DarqSh/bap-novosad/NSI/NSI_latex_submit/design/design.tex

\chapter{Design of a Platform}
This chapter will firstly go over the existing DIY solutions for 360° LiDAR platforms discovered during the research for this project, analysing their pros and cons.
Subsequently, the proposed design is presented, along with the chosen design decisions and their justifications.

\input{design/existing_solutions/existing_solutions.tex}
\input{design/proposed_design/proposed_design.tex}
\input{design/gearbox_design/gearbox_design.tex}
\input{design/platform_showcase/platform_showcase.tex}
