DarqSh/bap-novosad/NSI/NSI_latex_submit/design/existing_solutions/existing_solutions.tex

\section{Existing Amateur Solutions for Environmental Mapping}
\label{sec:amateur_solutions}
\subsection{Using a Single-Point \gls{lidar} module}

One of the most straightforward approaches to achieve 360° environmental mapping is to utilise a single-point \gls{lidar} module mounted on a platform which can rotate and tilt. 
The implementation could be found in \cite{lidar_design_1}.
\begin{figure}
    \centering
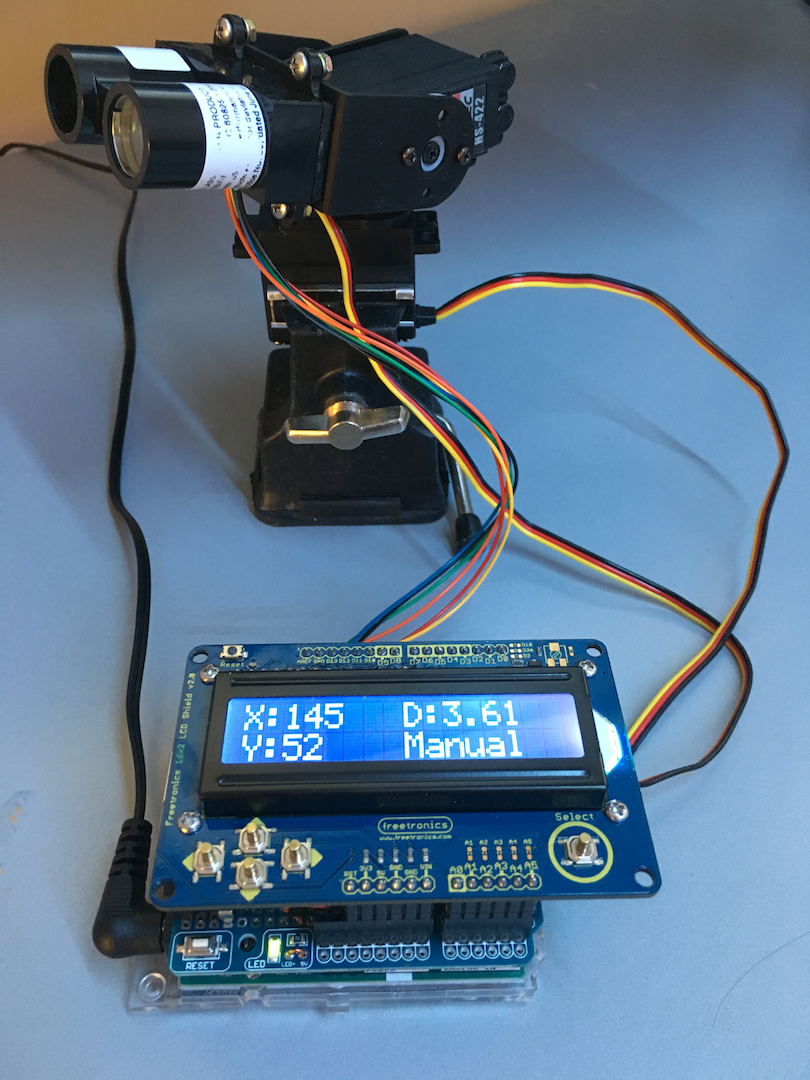
[picture p7: NSI/NSI_latex_submit/design/existing_solutions/3D_1.png]
    
    \caption{Implementation in project \cite{lidar_design_1} using a single-point \gls{lidar}}
    \label{ph:lidar_design_1}
\end{figure}

\begin{tabular}{p{0.45\linewidth} p{0.45\linewidth}}
\textbf{Pros} & \textbf{Cons} \\
\begin{itemize}[label=\textcolor{green!60!black}{\textbf{+}}]
    \item Single-point \gls{lidar}s are the most cost-effective among all existing types
    \item Simple design
\end{itemize}
&
\begin{itemize}[label=\textcolor{red!70!black}{\textbf{--}}]
    \item Slow data acquisition relative to methods leveraging 2D \gls{lidar}'s speed
    \item Movement of lidar may introduce inaccuracies in distance measurements, which need to be compensated for in code if we want to assume that all points are measured from a single position in space
\end{itemize}
\end{tabular}

\subsection{Using a Single-Point \gls{lidar} and a Mirror}
The following approach was used in \cite{lidar_design_2}. A single-point \gls{lidar} is placed below a rotating mirror, which reflects the laser beam horizontally. 
As the mirror rotates, the laser beam scans the environment in 360-degree sweep. 
Moreover, by tilting the mirror at an angle, vertical scanning can also be achieved, allowing for the acquisition of the whole scene.

\begin{figure}
    \centering
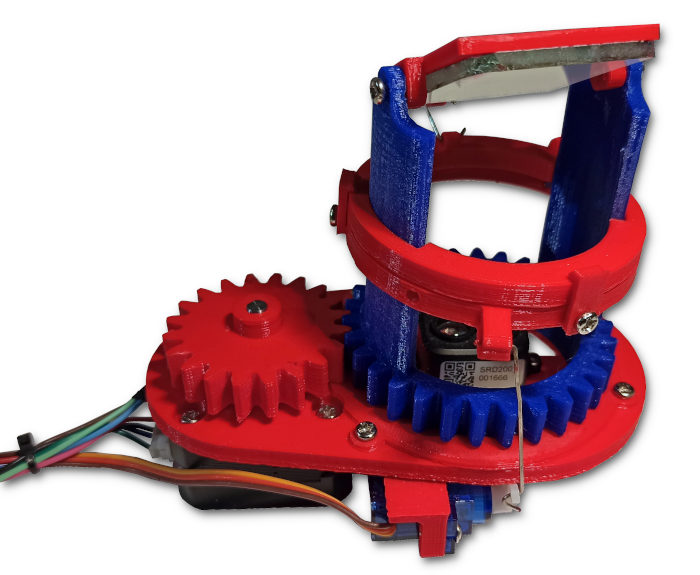
[picture p8: NSI/NSI_latex_submit/design/existing_solutions/3D_2.jpg]
    
    \caption{Implementation in project \cite{lidar_design_2} using a single-point \gls{lidar} and a mirror}
    \label{ph:lidar_design_2}
\end{figure}

\begin{tabular}{p{0.45\linewidth} p{0.45\linewidth}}
\textbf{Pros} & \textbf{Cons} \\
\begin{itemize}[label=\textcolor{green!60!black}{\textbf{+}}]
    \item Cost-effectiveness as in previous implementation
    \item Simple design
    \item Much easier to correct the distance measurement since the \gls{lidar} is stationary and the distance from it to the mirror is known.
\end{itemize}
&
\begin{itemize}[label=\textcolor{red!70!black}{\textbf{--}}]
    \item Slow data acquisition relative to methods leveraging 2D \gls{lidar}'s speed
    \item Mirror quality may affect the accuracy of distance measurements
    \item Mechanical structure holding the mirror may introduce vibrations, thus affecting measurement accuracy
\end{itemize}
\end{tabular}

\subsection{Using a 2D \gls{lidar} Mounted on a Tilting Platform}
\label{sec:tilting_platform}
This approach utilises a 2D \gls{lidar} sensor mounted on a platform that can tilt the sensor side to side, as demonstrated in \cite{lidar_design_3}. The 2D \gls{lidar} scans the environment in a horizontal plane, while the tilting mechanism allows for vertical scanning.

\begin{figure}
    \centering
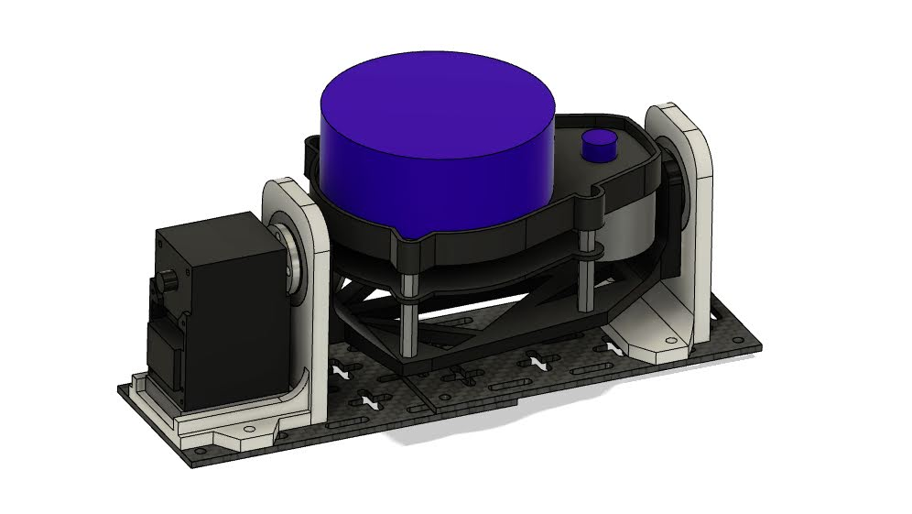
[picture p9: NSI/NSI_latex_submit/design/existing_solutions/3D_3.jpg]
    
    \caption{Implementation in project \cite{lidar_design_3} using a tilting platform}
    \label{ph:lidar_design_3}
\end{figure}

\begin{tabular}{p{0.45\linewidth} p{0.45\linewidth}}
\textbf{Pros} & \textbf{Cons} \\
\begin{itemize}[label=\textcolor{green!60!black}{\textbf{+}}]
    \item Faster data acquisition compared to solutions with single-point \gls{lidar} measurements
    \item Higher resolution given by the use of a 2D \gls{lidar} sensor
    \item This design could be potentially used for \gls{slam} applications, given the higher speed
\end{itemize}
&
\begin{itemize}[label=\textcolor{red!70!black}{\textbf{--}}]
    \item More expensive than single-point \gls{lidar} solutions
    \item Point distribution is non-uniform due to the tilting mechanism, which produces denser point clouds on the axis of tilting (see \cref{fig:tilt_pointCloud})
    \item Mechanical design is more prone to vibrations produced by the \gls{lidar} itself, affecting measurement accuracy
\end{itemize}
\end{tabular}
\begin{figure}[H]
    \centering
    \input{design/existing_solutions/tilt_pointCloud.tex}
    \caption{Simulation of an obtained point cloud using a tilting platform}
    \label{fig:tilt_pointCloud}
\end{figure}
