DarqSh/bap-novosad/NSI/NSI_latex_submit/zadani.tex

\chapter{Specification of Assignment}
There are used various methods based on the evaluation of the ranging signal to map the topology of the
environment. Study these methods with a focus on the use of lidar signals. Based on the study results, design
a method and algorithms for using a directional beam lidar module or an omnidirectional lidar module for
scanning a 3D space. Assume that the lidar will be mounted on a platform that will either be linearly lifted,
angularly tilted and/or rotated. The goal is to design the processing of the output signal of the lidar module so
that a 3D image of the scanned space can be displayed and propose the construction solution of the lidar
installation.
