DarqSh/bap-novosad/psani_miniproject/miniproject/_glossary.tex

\usepackage[toc=false]{glossaries-extra} % glossary functionality for acronyms
\setabbreviationstyle[acronym]{long-short} % the first time an abbreviation is used, it will be represented in long-short format
\newacronym{lidar}{LiDAR}{Light Detection and Ranging} %\newacronym{label}{abbrv}{long}
\newacronym{dsp}{DSP}{Digital Signal Processing}
\newacronym{slam}{SLAM}{Simultaneous Localisation and Mapping}
\makeglossaries
