DarqSh/bap-novosad/defense_presentation/main_presentation.pdf

## 3D Mapping Based on LiDAR Signal Processing

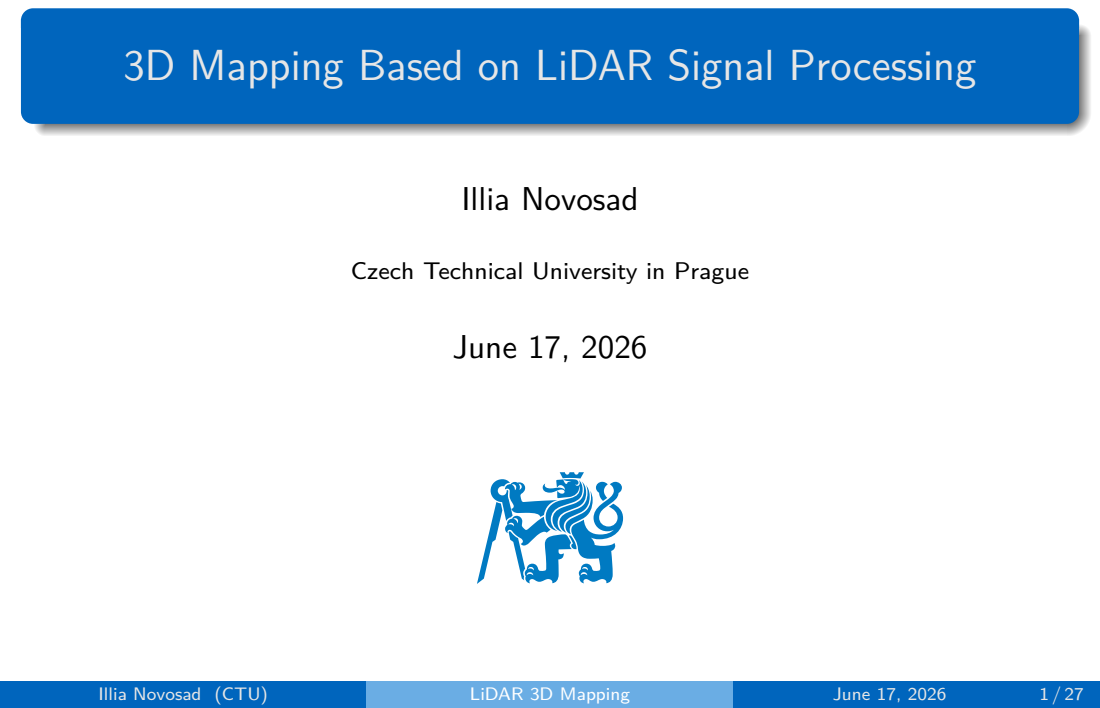
[picture p28: page 1]
Illia Novosad; Illia Novosad (CTU); LiDAR 3D Mapping; June 17, 2026

Czech Technical University in Prague
June 17, 2026

## Obsah

1 Introduction
2 Platform Design
Existing Amateur Solutions for 3D Scanning Point Cloud Visualisation at Different Tilt Angles Dependence of Scan Spacing Sscan on Tilt Angle θ Effect of Reduction Ratio R on Scan Spacing Sscan Platform Showcase
3 Electronics and Software
Electronic Design
Software Architecture
4 Experimental Results
Room Scan
Transformation Corrections Comparison with a Photograph
5 Conclusion
6 Odpovědi na otázky
Illia Novosad (CTU) | LiDAR 3D Mapping | June 17, 2026 | 2 / 27

## Introduction

Commercially available 3D LiDAR solutions:


Unitree 4D L1

Price: 250 e

Solution: use a cheaper 2D LiDAR and design a stepper-motor-driven platform for it

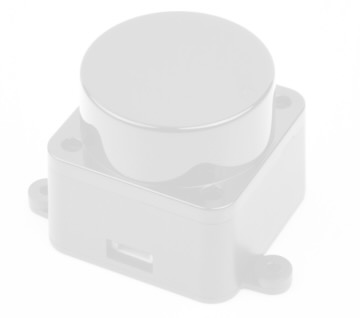
[picture p29: figure]

STL-19P (https://amzn.eu/d/0cCyszli)

Price: 80 e

Illia Novosad (CTU) | LiDAR 3D Mapping | June 17, 2026 | 3 / 27

## Introduction

Commercially available 3D LiDAR solutions:

Unitree 4D L1

Price: 250 e

Solution: use a cheaper 2D LiDAR and design a stepper-motor-driven platform for it


STL-19P (https://amzn.eu/d/0cCyszli)

Price: 80 e

Illia Novosad (CTU) | LiDAR 3D Mapping | June 17, 2026 | 3 / 27

## Table of Contents

1 Introduction
2 Platform Design
Existing Amateur Solutions for 3D Scanning Point Cloud Visualisation at Different Tilt Angles Dependence of Scan Spacing Sscan on Tilt Angle θ Effect of Reduction Ratio R on Scan Spacing Sscan Platform Showcase
3 Electronics and Software
Electronic Design
Software Architecture
4 Experimental Results
Room Scan
Transformation Corrections Comparison with a Photograph
5 Conclusion
6 Odpovědi na otázky
Illia Novosad (CTU) | LiDAR 3D Mapping | June 17, 2026 | 4 / 27

## Existing Amateur Solutions for 3D Scanning

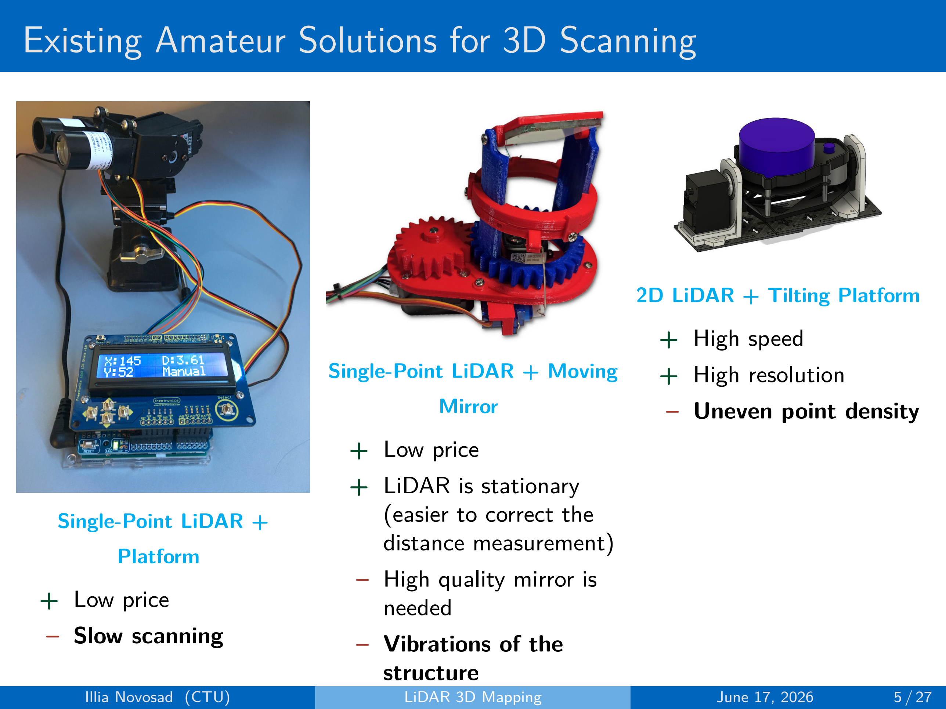
[picture p30: page 6]

Single-Point LiDAR +
Platform (https://www.qcontinuum.org/lidar-scanner)
+ Low price
– Slow scanning

Single-Point LiDAR + Moving Mirror (https://charleslabs.fr/en/project-3D+Lidar+Scanner+MK2)
+ Low price
+ LiDAR is stationary
(easier to correct the
distance measurement)
– High quality mirror is
needed
– Vibrations of the
structure

2D LiDAR + Tilting Platform (http://zlethic.com/diy-3dlidar/) + High speed
+ High resolution
– Uneven point density
Illia Novosad (CTU) | LiDAR 3D Mapping | June 17, 2026 | 5 / 27

## Point Cloud Visualisation at Different Tilt Angles

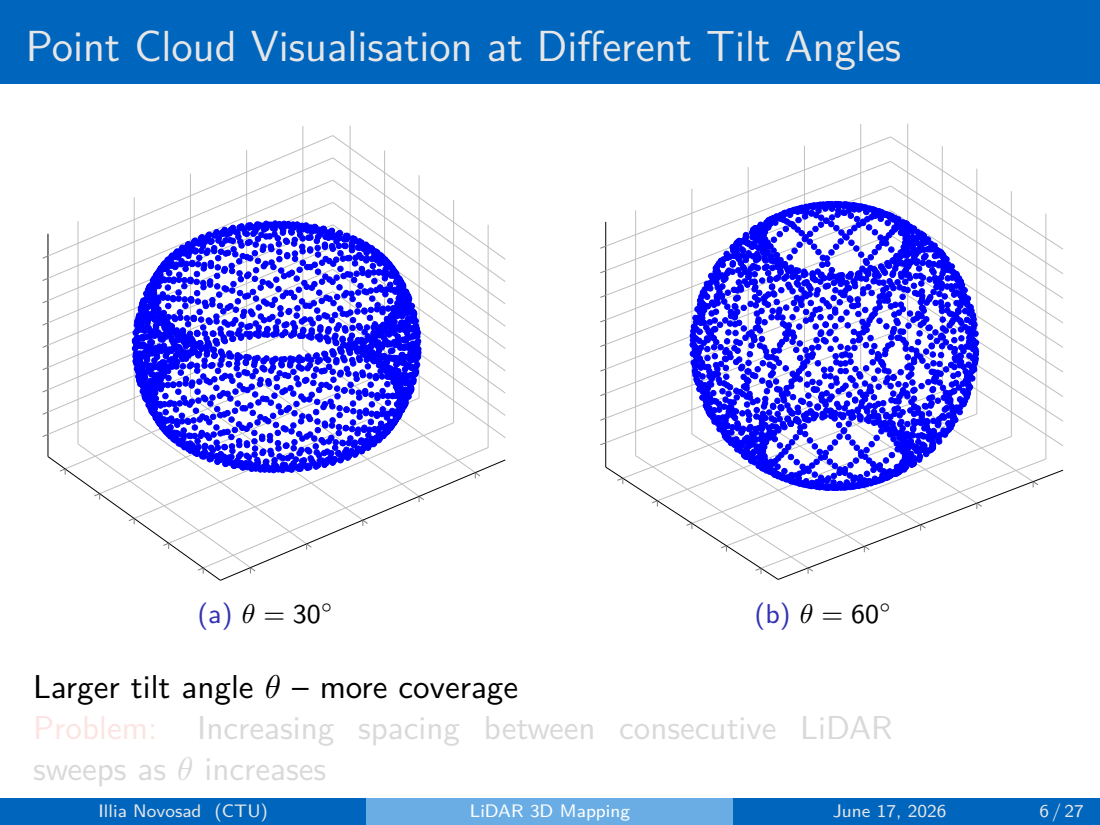
[picture p31: page 7]
Illia Novosad (CTU); LiDAR 3D Mapping; June 17, 2026

Larger tilt angle θ – more coverage
Problem: Increasing spacing between consecutive LiDAR
sweeps as θ increases

## Point Cloud Visualisation at Different Tilt Angles

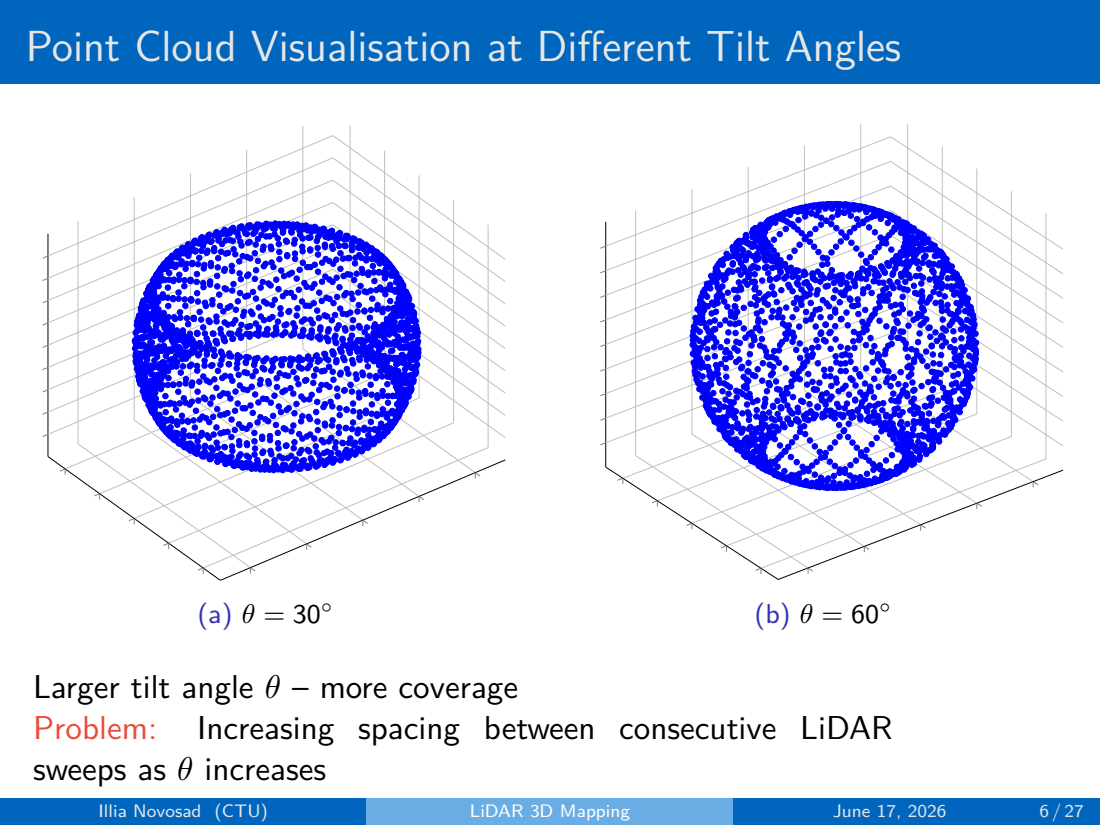
[picture p32: page 8]
Illia Novosad (CTU); LiDAR 3D Mapping; June 17, 2026

Larger tilt angle θ – more coverage
Problem: Increasing spacing between consecutive LiDAR
sweeps as θ increases

## Dependence of Scan Spacing Sscan on Tilt Angle θ

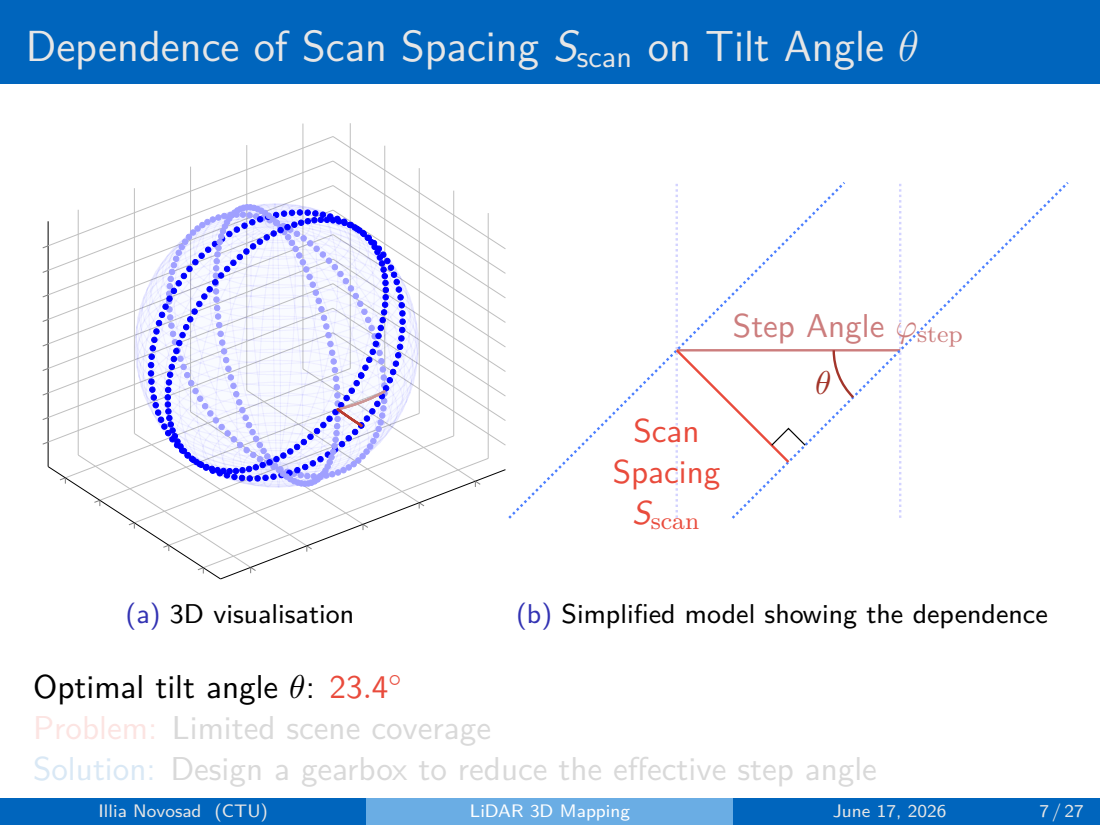
[picture p33: page 9]
Scan Spacing Sscan; Illia Novosad (CTU); LiDAR 3D Mapping; June 17, 2026

Step Angle ϕstep

(a) 3D visualisation
Optimal tilt angle θ: 23.4
Problem: Limited scene coverage
Solution: Design a gearbox to reduce the effective step angle

(b) Simplified model showing the dependence

## Dependence of Scan Spacing Sscan on Tilt Angle θ

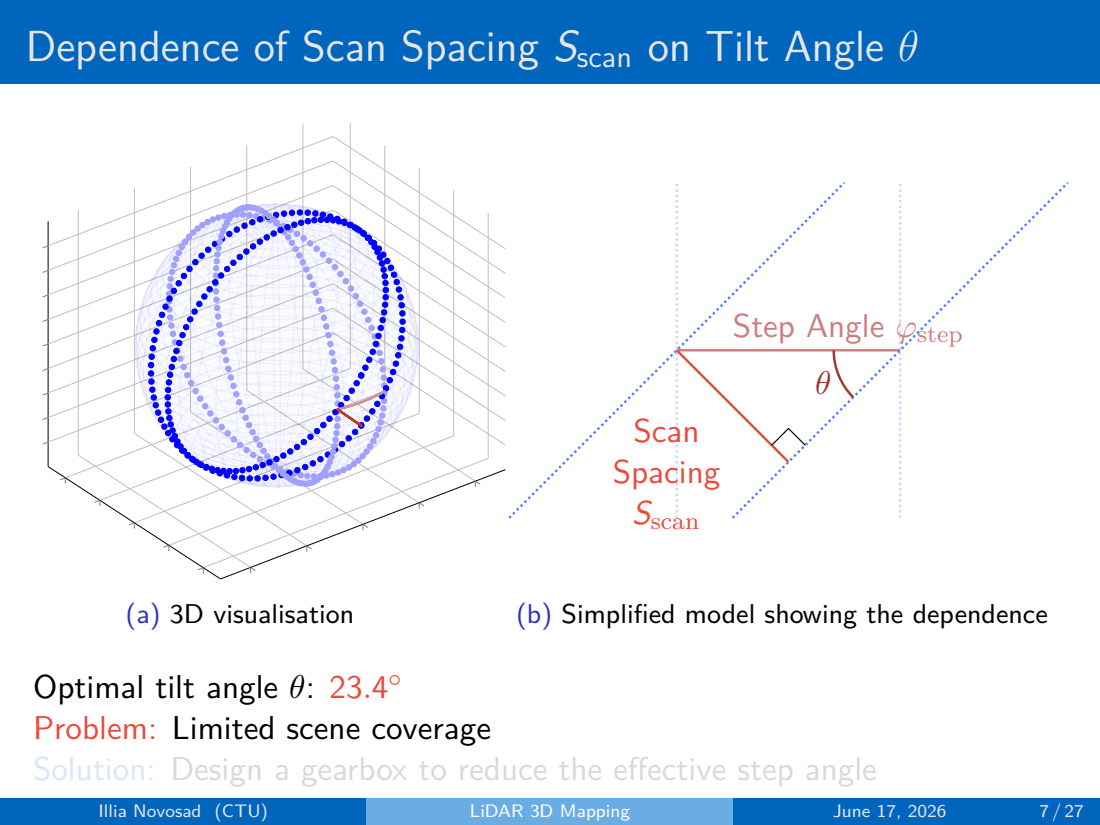
[picture p34: page 10]
Scan Spacing Sscan; Illia Novosad (CTU); LiDAR 3D Mapping; June 17, 2026

Step Angle ϕstep

(a) 3D visualisation
Optimal tilt angle θ: 23.4
Problem: Limited scene coverage
Solution: Design a gearbox to reduce the effective step angle

(b) Simplified model showing the dependence

## Dependence of Scan Spacing Sscan on Tilt Angle θ

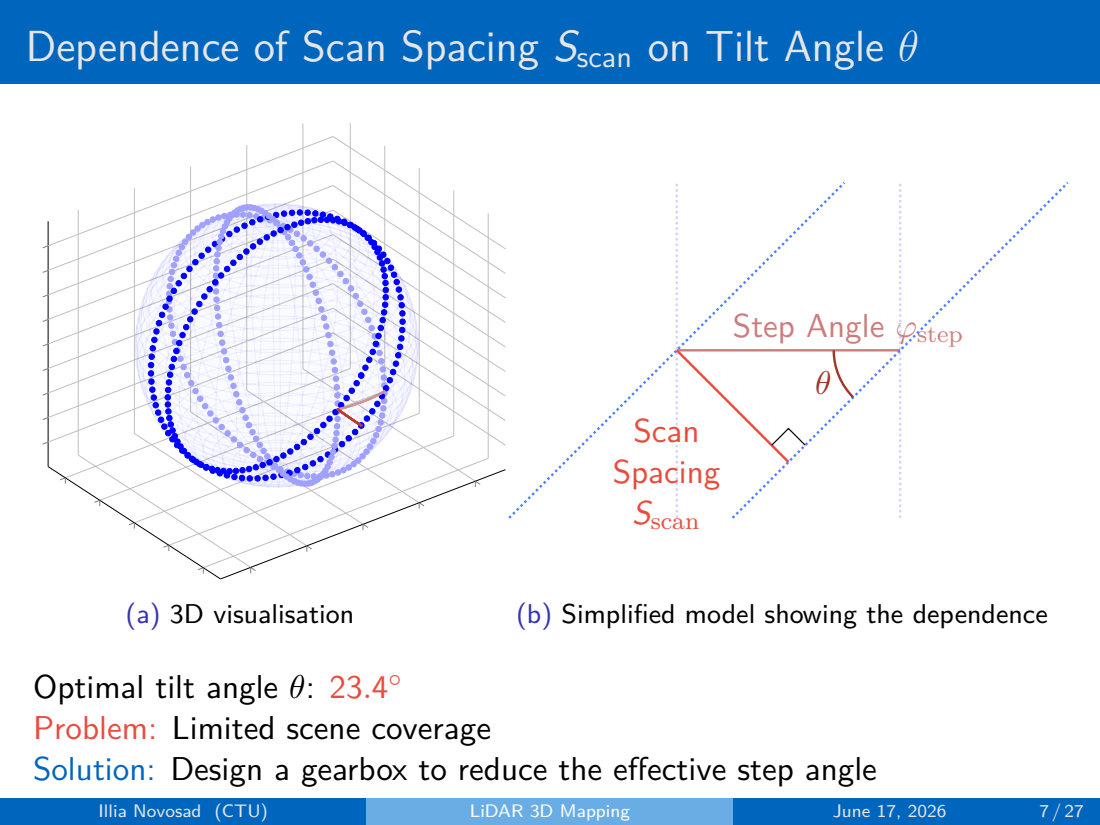
[picture p35: page 11]
Scan Spacing Sscan; Illia Novosad (CTU); LiDAR 3D Mapping; June 17, 2026

Step Angle ϕstep

(a) 3D visualisation
Optimal tilt angle θ: 23.4
Problem: Limited scene coverage
Solution: Design a gearbox to reduce the effective step angle

(b) Simplified model showing the dependence

## Effect of Reduction Ratio R on Scan Spacing Sscan

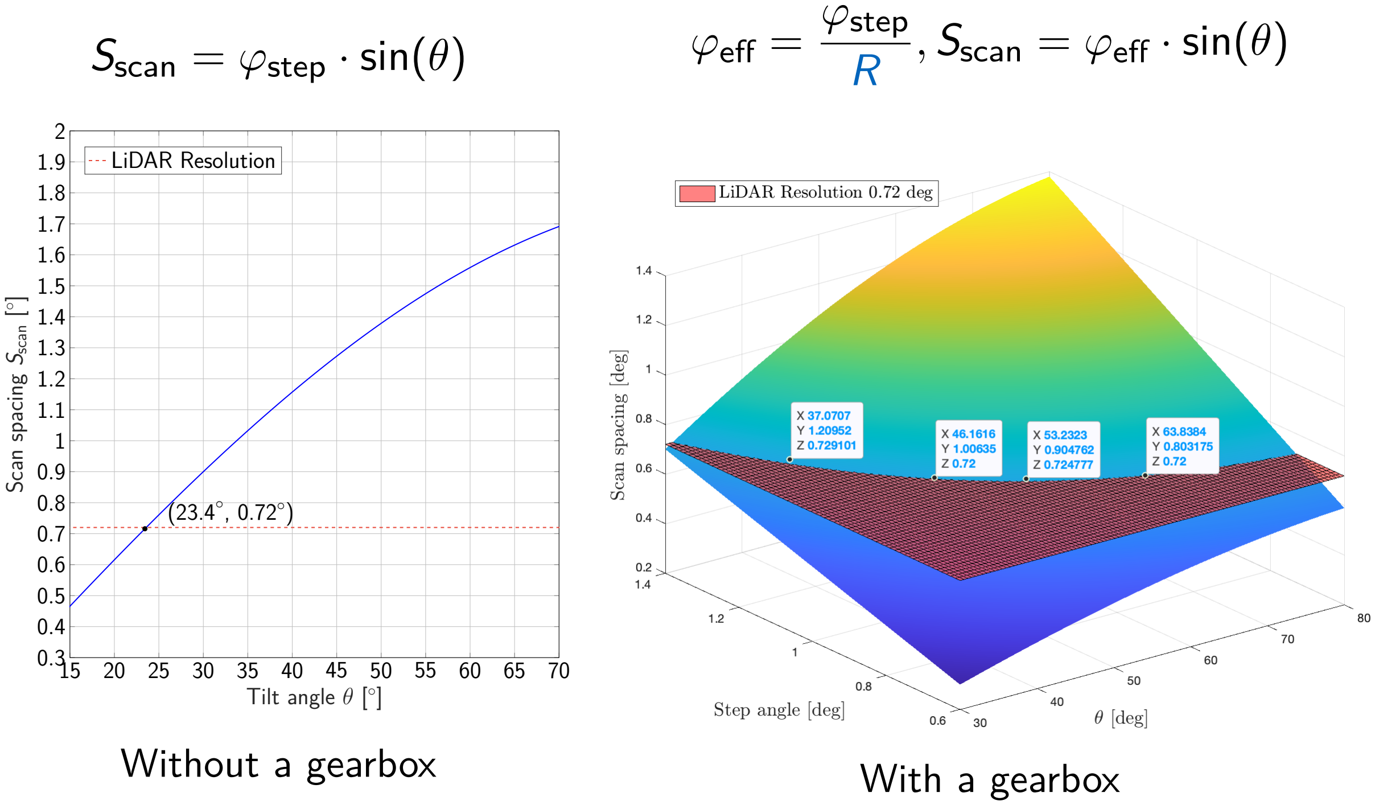
[picture p36: figure]
Sscan = ϕstep · sin(θ); Tilt angle θ [◦; ] Scan spacing Sscan [◦; LiDAR Resolution; Without a gearbox; ϕeff =; ϕstep R; , Sscan = ϕeff · sin(θ); With a gearbox

Illia Novosad (CTU) | LiDAR 3D Mapping | June 17, 2026 | 8 / 27

## Platform Showcase

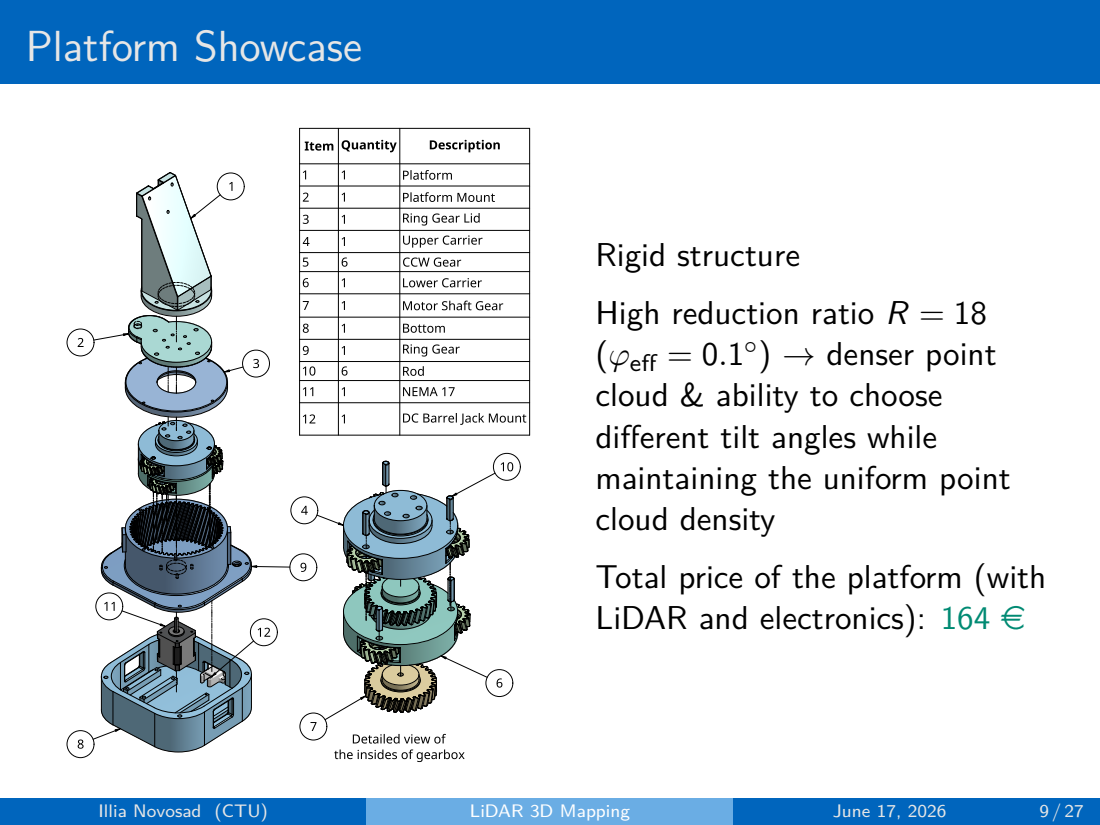
[picture p37: page 13]
) → denser point; Illia Novosad (CTU); LiDAR 3D Mapping; June 17, 2026

Rigid structure
High reduction ratio R = 18
(ϕeff = 0.1
cloud & ability to choose
different tilt angles while
maintaining the uniform point
cloud density
Total price of the platform (with
LiDAR and electronics): 164 e

## Table of Contents

1 Introduction
2 Platform Design
Existing Amateur Solutions for 3D Scanning Point Cloud Visualisation at Different Tilt Angles Dependence of Scan Spacing Sscan on Tilt Angle θ Effect of Reduction Ratio R on Scan Spacing Sscan Platform Showcase
3 Electronics and Software
Electronic Design
Software Architecture
4 Experimental Results
Room Scan
Transformation Corrections Comparison with a Photograph
5 Conclusion
6 Odpovědi na otázky
Illia Novosad (CTU) | LiDAR 3D Mapping | June 17, 2026 | 10 / 27

## Electronic Design

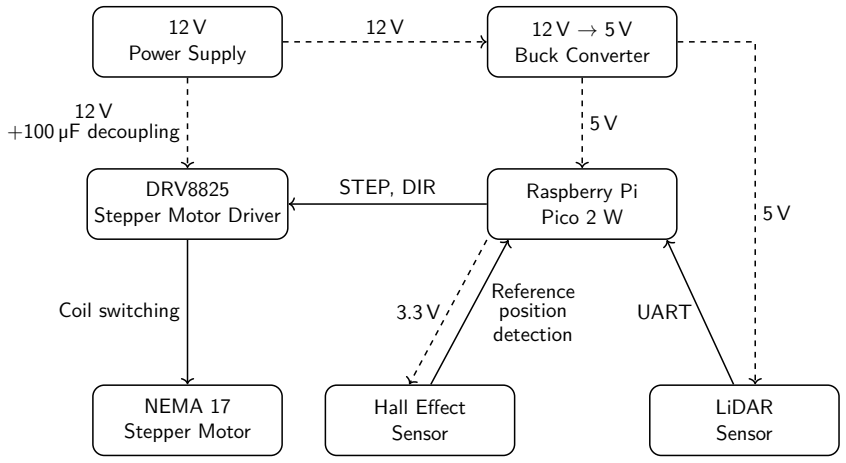
[picture p38: figure]
12 V Power Supply; DRV8825 Stepper Motor Driver; 12 V → 5 V Buck Converter; NEMA 17 Stepper Motor; Raspberry Pi Pico 2 W; LiDAR Sensor; Hall Effect Sensor; 12 V +100 µF decoupling; Coil switching; STEP, DIR; UART; Reference position detection

Illia Novosad (CTU) | LiDAR 3D Mapping | June 17, 2026 | 11 / 27

## Software Architecture

LiDAR | Pico 2 W | PC | Open3D UART | Wi-Fi

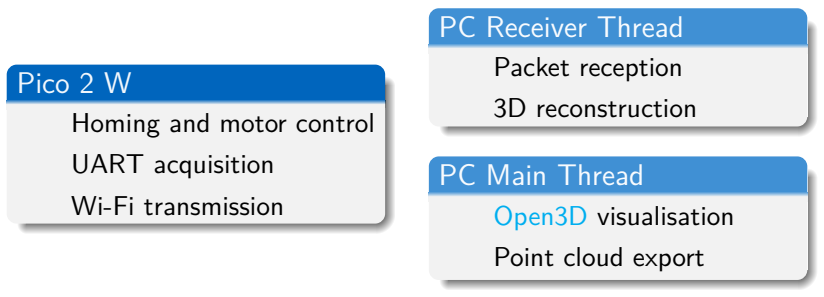
[picture p39: figure]
Pico 2 W Homing and motor control UART acquisition Wi-Fi transmission; PC Receiver Thread Packet reception 3D reconstruction PC Main Thread Open3D visualisation Point cloud export

Illia Novosad (CTU) | LiDAR 3D Mapping | June 17, 2026 | 12 / 27

## Table of Contents

1 Introduction
2 Platform Design
Existing Amateur Solutions for 3D Scanning Point Cloud Visualisation at Different Tilt Angles Dependence of Scan Spacing Sscan on Tilt Angle θ Effect of Reduction Ratio R on Scan Spacing Sscan Platform Showcase
3 Electronics and Software
Electronic Design
Software Architecture
4 Experimental Results
Room Scan
Transformation Corrections Comparison with a Photograph
5 Conclusion
6 Odpovědi na otázky
Illia Novosad (CTU) | LiDAR 3D Mapping | June 17, 2026 | 13 / 27

## Room Scan

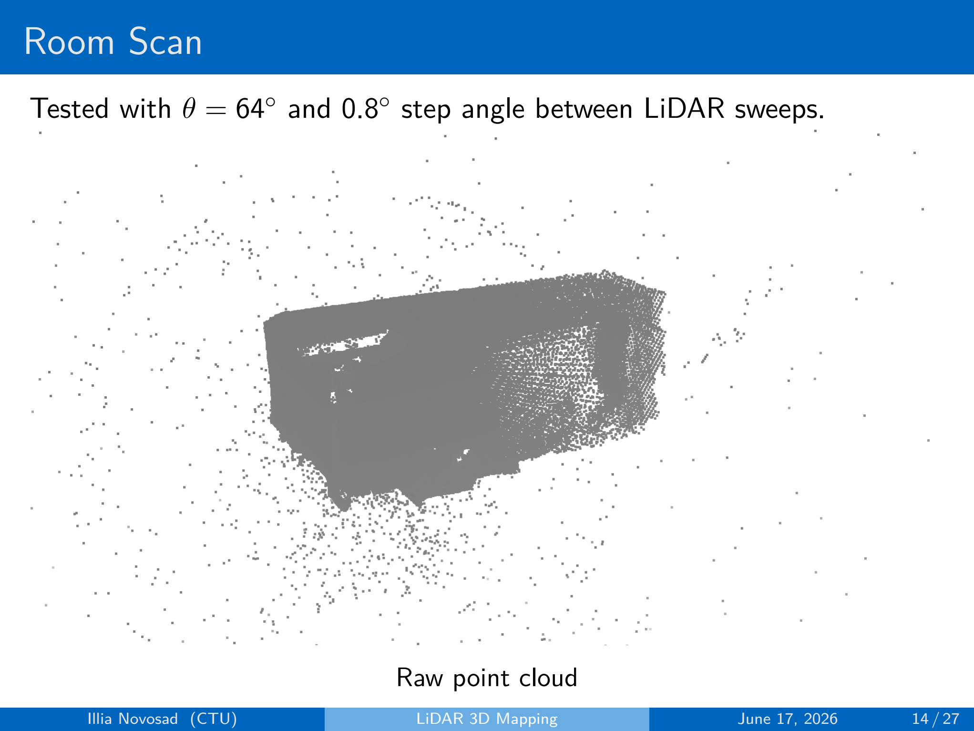
[picture p40: page 18]

Tested with θ = 64◦

and 0.8◦

step angle between LiDAR sweeps.

Raw point cloud

Illia Novosad (CTU) | LiDAR 3D Mapping | June 17, 2026 | 14 / 27

## Room Scan

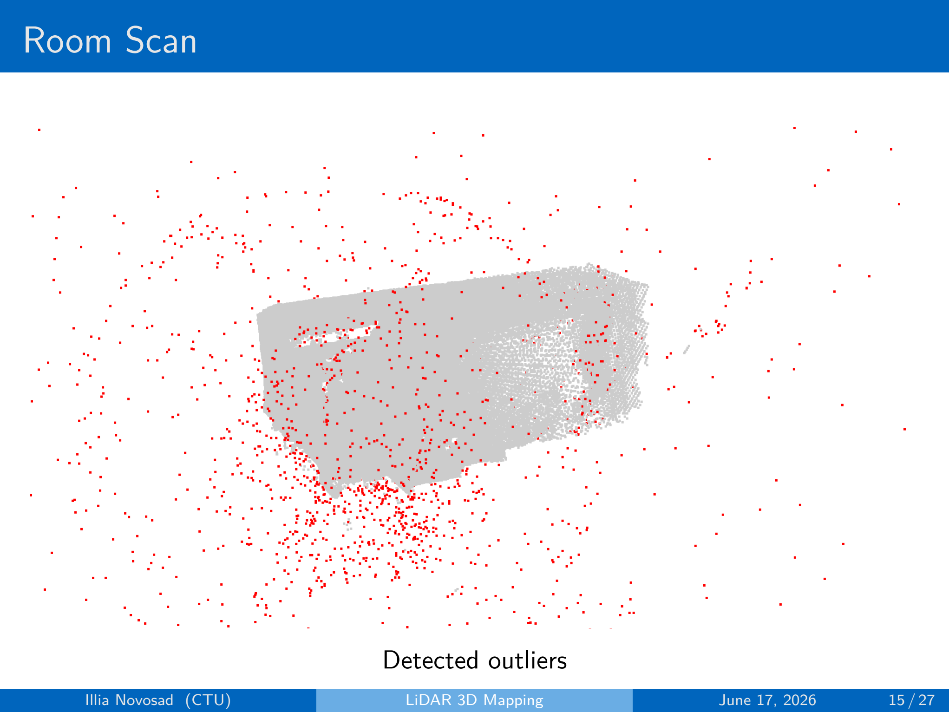
[picture p41: page 19]

Detected outliers

Illia Novosad (CTU) | LiDAR 3D Mapping | June 17, 2026 | 15 / 27

## Room Scan

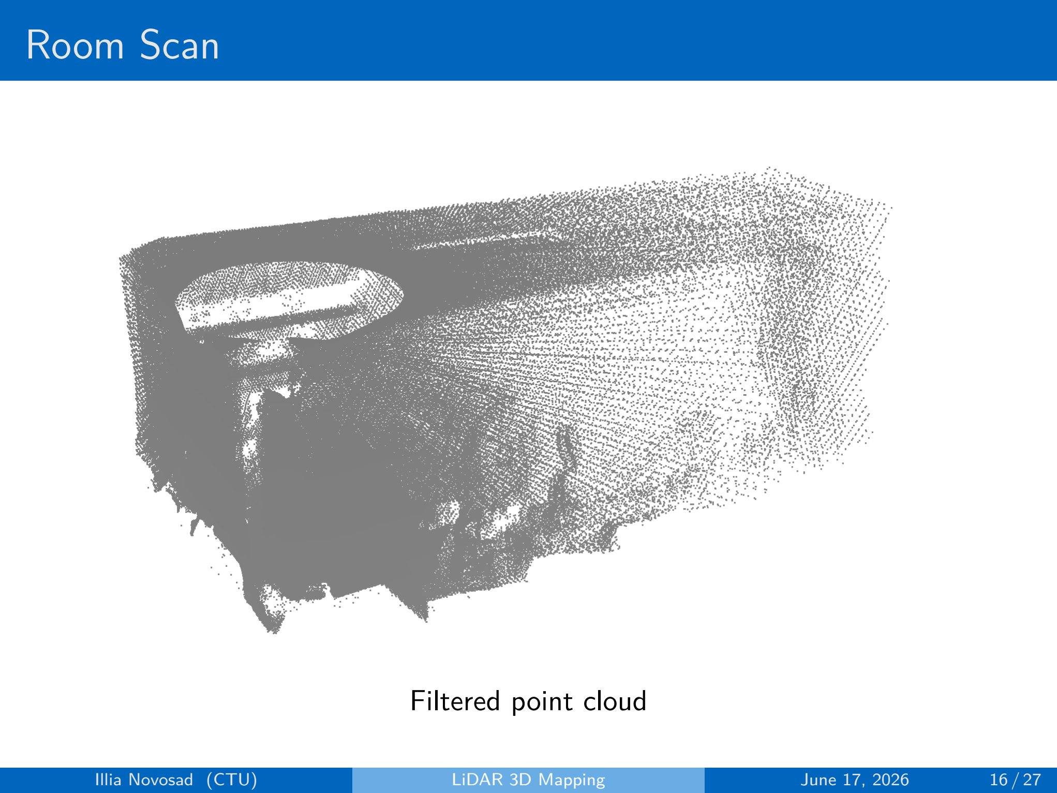
[picture p42: page 20]

Filtered point cloud

Illia Novosad (CTU) | LiDAR 3D Mapping | June 17, 2026 | 16 / 27

## Transformation Corrections

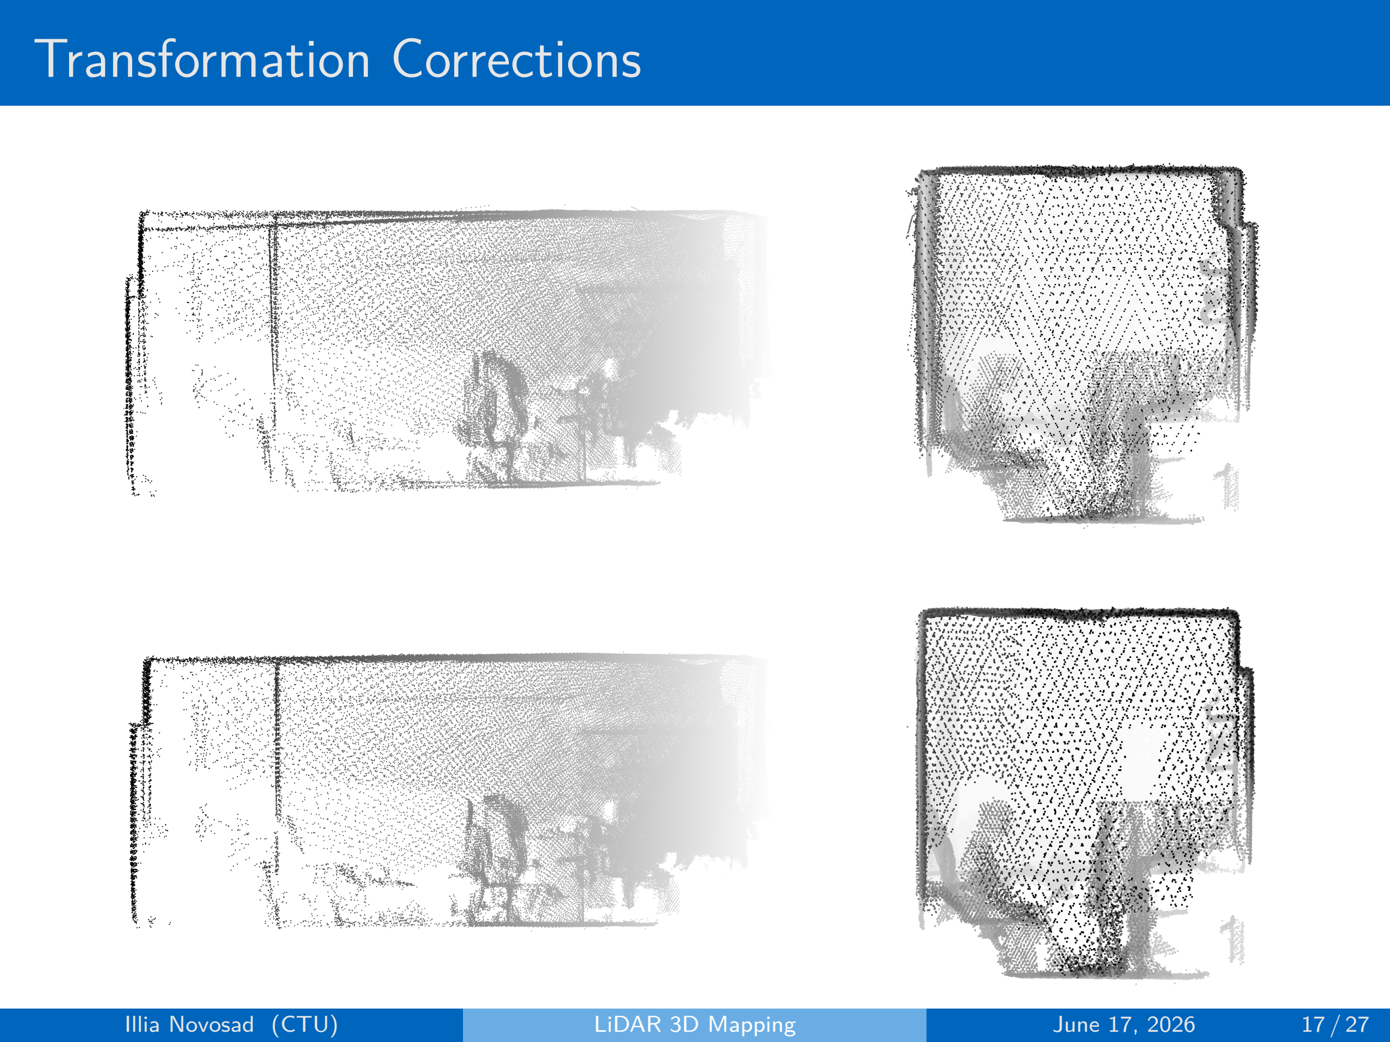
[picture p43: page 21]

Illia Novosad (CTU) | LiDAR 3D Mapping | June 17, 2026 | 17 / 27

## Comparison with a Photograph

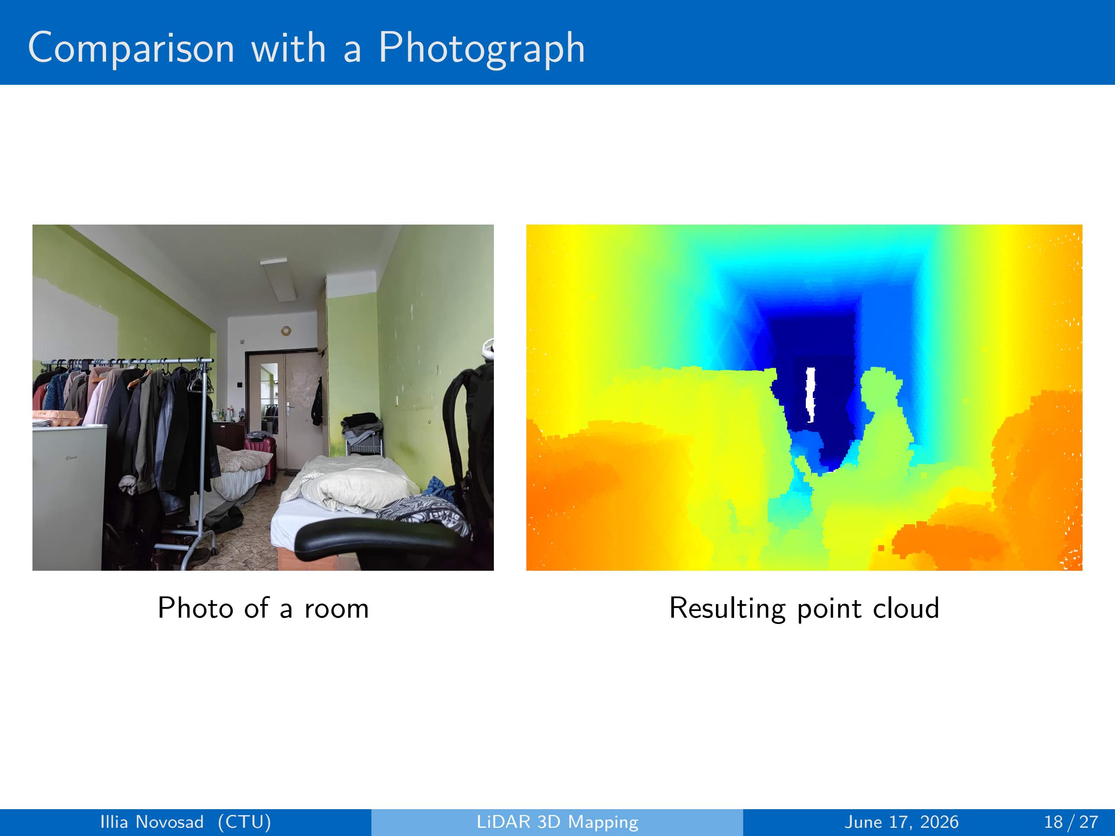
[picture p44: page 22]

Photo of a room | Resulting point cloud
Illia Novosad (CTU) | LiDAR 3D Mapping | June 17, 2026 | 18 / 27

## Table of Contents

1 Introduction
2 Platform Design
Existing Amateur Solutions for 3D Scanning Point Cloud Visualisation at Different Tilt Angles Dependence of Scan Spacing Sscan on Tilt Angle θ Effect of Reduction Ratio R on Scan Spacing Sscan Platform Showcase
3 Electronics and Software
Electronic Design
Software Architecture
4 Experimental Results
Room Scan
Transformation Corrections Comparison with a Photograph
5 Conclusion
6 Odpovědi na otázky
Illia Novosad (CTU) | LiDAR 3D Mapping | June 17, 2026 | 19 / 27

## Conclusion

A platform enabling 3D reconstruction with 2D LiDAR was built. It features a gearbox with a high reduction ratio, allowing for dense point clouds even at large tilt angles.
Code for data acquisition, processing and 3D reconstruction visualisation was written.
The prototype was tested by scanning a room, transformation corrections were applied.
Illia Novosad (CTU) | LiDAR 3D Mapping | June 17, 2026 | 20 / 27

# Thank you for your attention!

Illia Novosad (CTU) | LiDAR 3D Mapping | June 17, 2026 | 21 / 27

## Table of Contents

1 Introduction
2 Platform Design
Existing Amateur Solutions for 3D Scanning Point Cloud Visualisation at Different Tilt Angles Dependence of Scan Spacing Sscan on Tilt Angle θ Effect of Reduction Ratio R on Scan Spacing Sscan Platform Showcase
3 Electronics and Software
Electronic Design
Software Architecture
4 Experimental Results
Room Scan
Transformation Corrections Comparison with a Photograph
5 Conclusion
6 Odpovědi na otázky
Illia Novosad (CTU) | LiDAR 3D Mapping | June 17, 2026 | 22 / 27

## Odpovědi na otázky

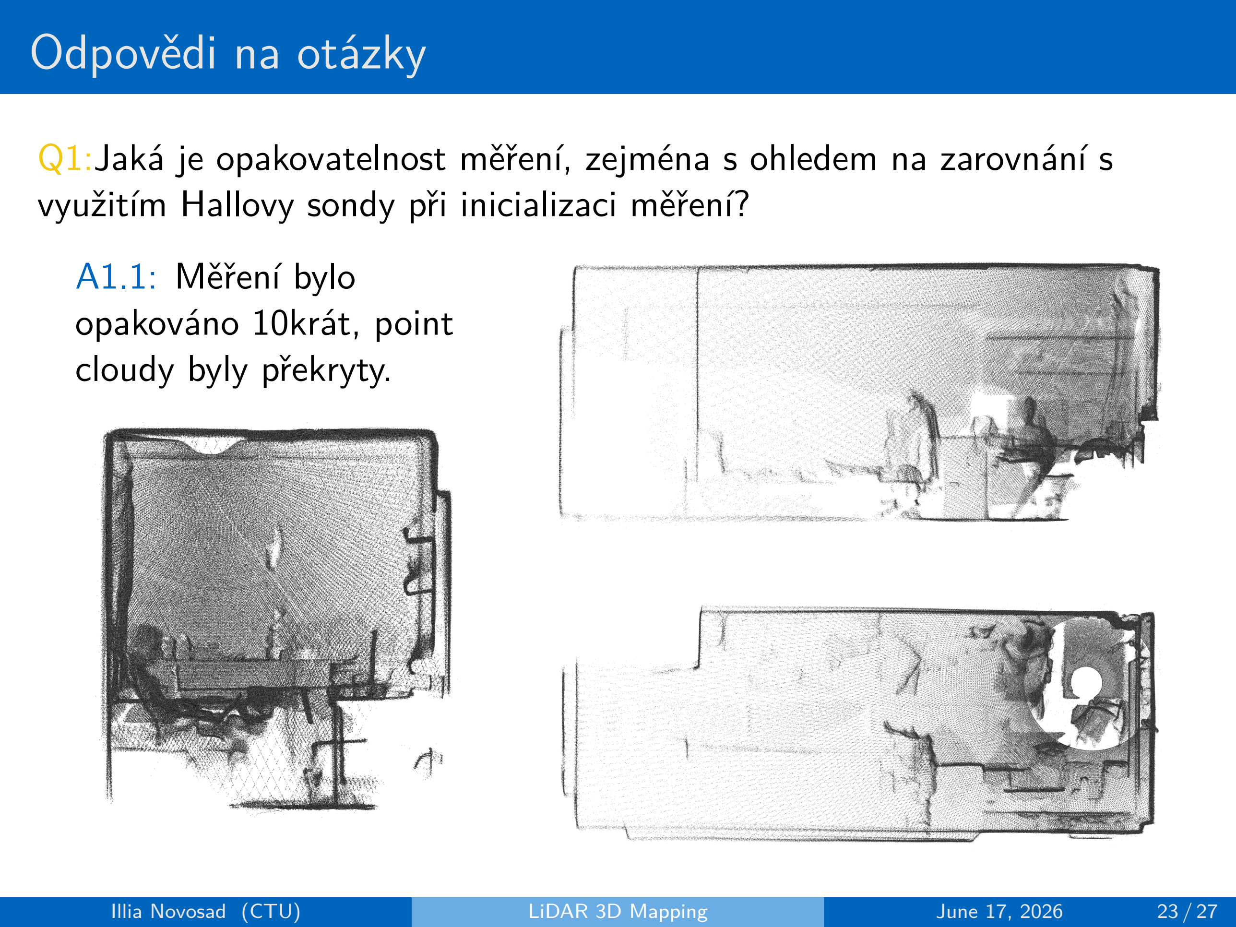
[picture p45: page 27]

Q1:Jaká je opakovatelnost měření, zejména s ohledem na zarovnání s využitím Hallovy sondy při inicializaci měření?
A1.1: Měření bylo
opakováno 10krát, point
cloudy byly překryty.
Illia Novosad (CTU) | LiDAR 3D Mapping | June 17, 2026 | 23 / 27

## Odpovědi na otázky

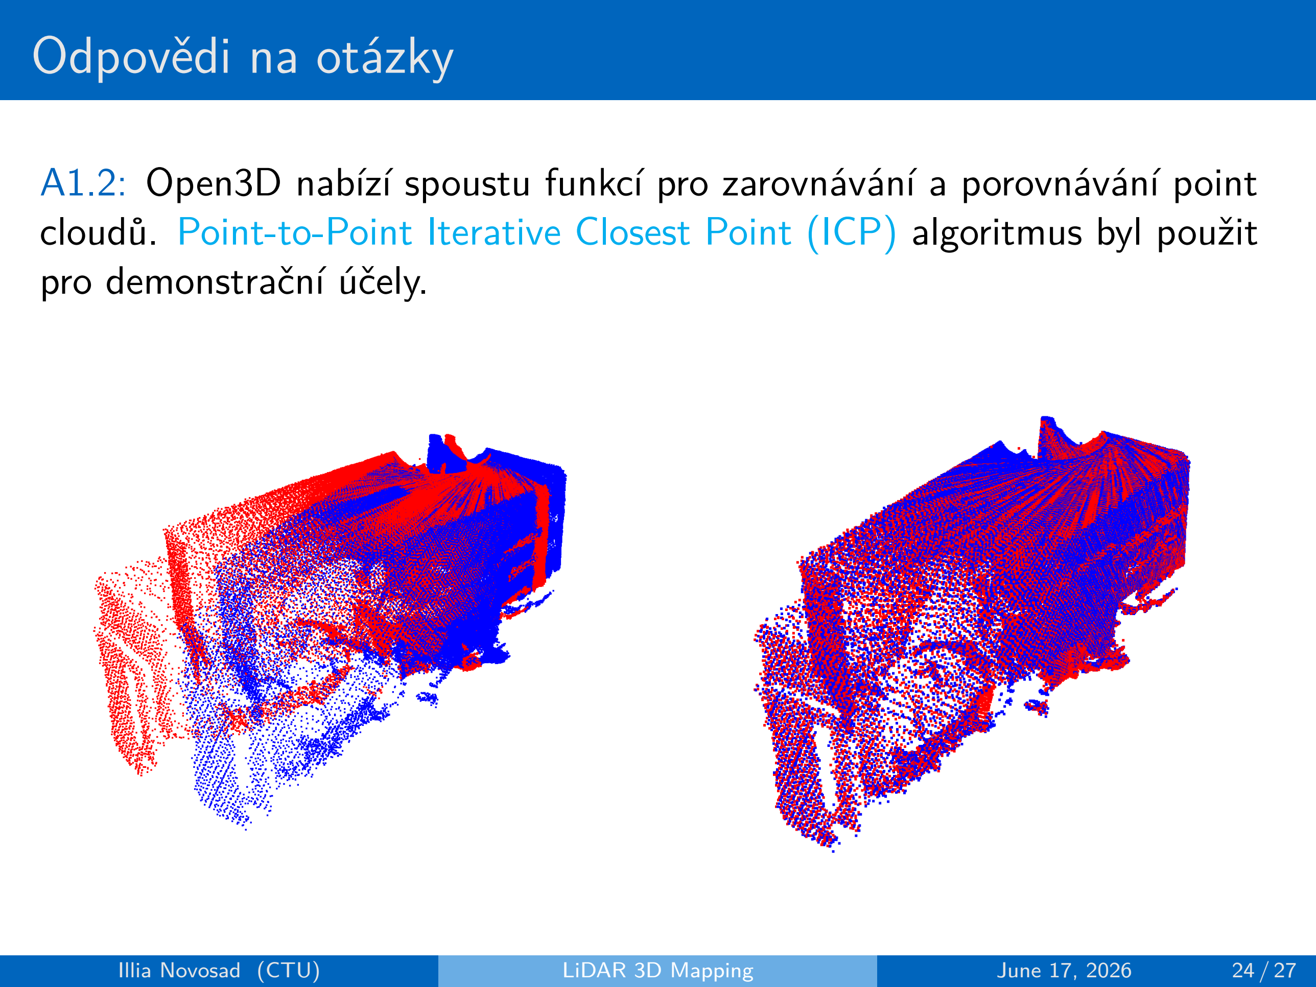
[picture p46: page 28]

A1.2: Open3D nabízí spoustu funkcí pro zarovnávání a porovnávání point cloudů. Point-to-Point Iterative Closest Point (ICP) (https://www.open3d.org/docs/release/tutorial/pipelines/icp_registration.html) algoritmus byl použit pro demonstrační účely.

Illia Novosad (CTU) | LiDAR 3D Mapping | June 17, 2026 | 24 / 27

## Odpovědi na otázky

Q2: Jaké mechanické úpravy by byly potřeba pro umožnění nepřetržité rotace senzoru? Jakým způsobem by bylo možné kontinuálně scanovat bez nutnosti inicializace orientace před každým spuštěním?

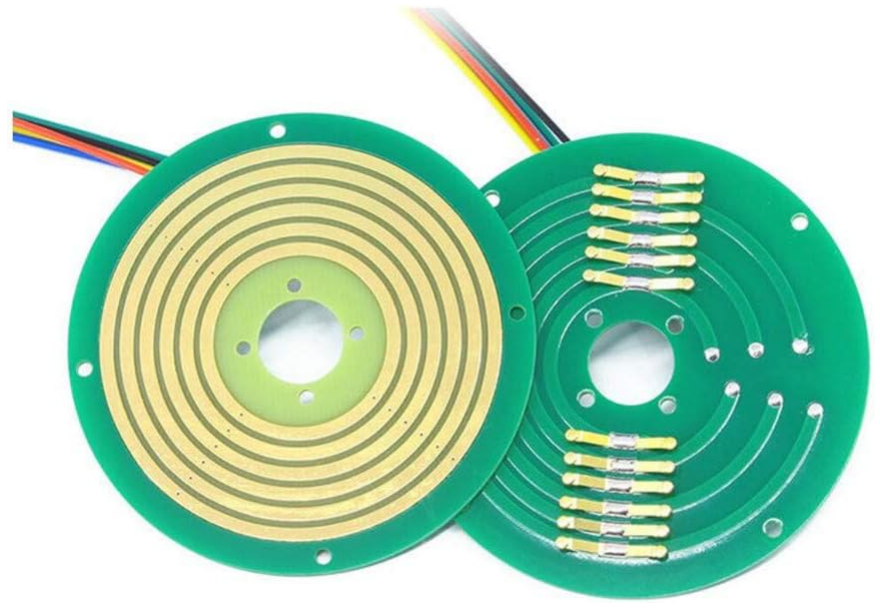
[picture p47: figure]

Cena: >100 $. Odkaz na
Amazon (https://www.amazon.com/Taidacent-Pancake-Rotating-Connector-Electrical/dp/B08FX7GJ8L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)

A2: V LiDARech se používají tzv. slip rings pro umožnění přenosu dat a napájení při otáčení o 360◦

Neintegrovaná řešení jsou avšak poměrně drahá.
Illia Novosad (CTU) | LiDAR 3D Mapping | June 17, 2026 | 25 / 27

## Odpovědi na otázky

Q3: Jaká je časová náročnost provedení celého 3D scanu?
A3: 450 kroků · 0.105 s/krok + 10 s(homing) ≈ 60 s. Reálná doba je však o cca 10 s delší kvůli přenosu dat přes Wi-Fi. V ojedinělých případech může dojít ke ztrátě spojení nebo komunikačním prodlevám, což může dále prodloužít dobu skenování.
Illia Novosad (CTU) | LiDAR 3D Mapping | June 17, 2026 | 26 / 27

## Odpovědi na otázky

Q4: Odpovídají rozměry nascanovaného pointcloudu reálným rozměrům místnosti? Jaké je relativní zastoupení outlierů v získaném pointcloudu? Rozměry pokoje: 5.87 ± 0.05m × 2.35 ± 0.05m (vzato z wiki Silicon Hill) (http://old-wiki.siliconhill.cz/Rozm%C4%9Bry_strahovsk%C3%A9ho_pokoje_a_n%C3%A1bytku_(mimo_blok_8))
P0, P1, P2, P3
|P1 - P0|: 5.9352 <- length
|P2 - P1|: 3.0441
|P3 - P2|: 2.3780 <- width
Rozměry nascanovaného pointcloudu jsou v rámci chyby měření

Unfiltered pcd: 494400 points
Outliers: | 3737 | points
Filtered pcd: 490663 points Removed points percentage: 0.76%

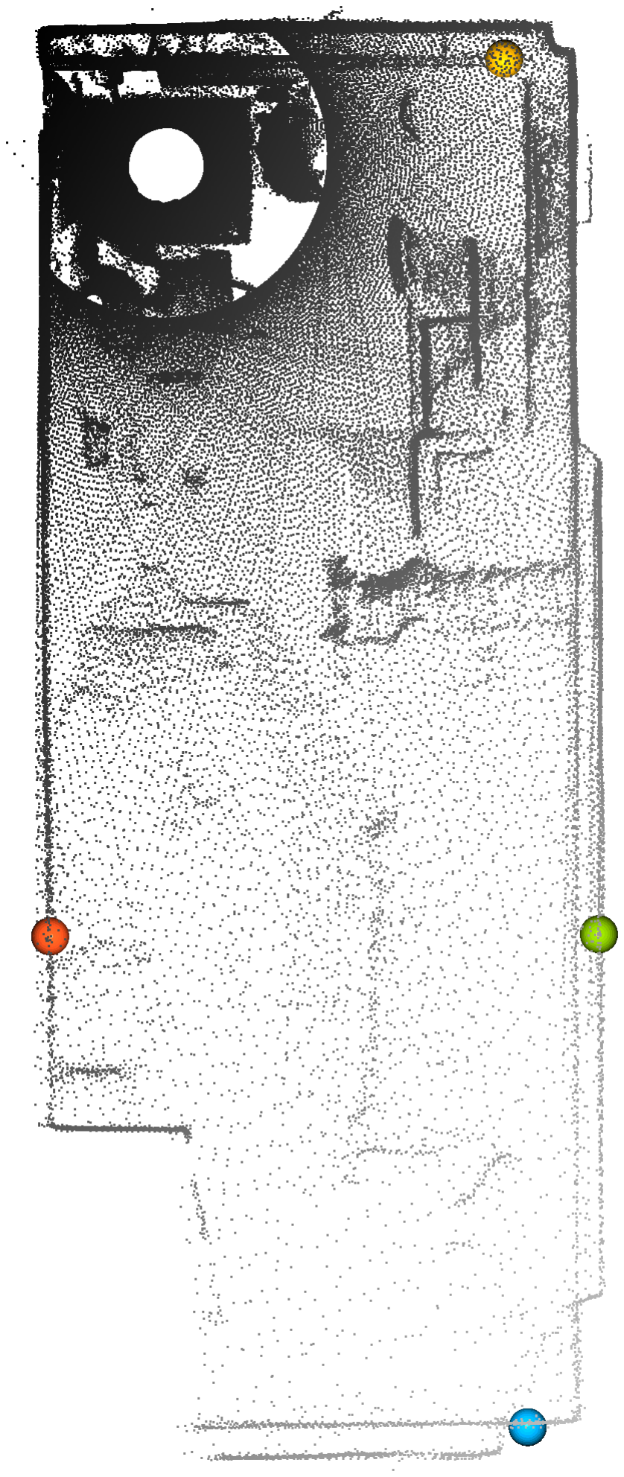
[picture p48: figure]

Illia Novosad (CTU) | LiDAR 3D Mapping | June 17, 2026 | 27 / 27
