DarqSh/bap-novosad/3D models/v1.1/v1.0 vs v1.1.png

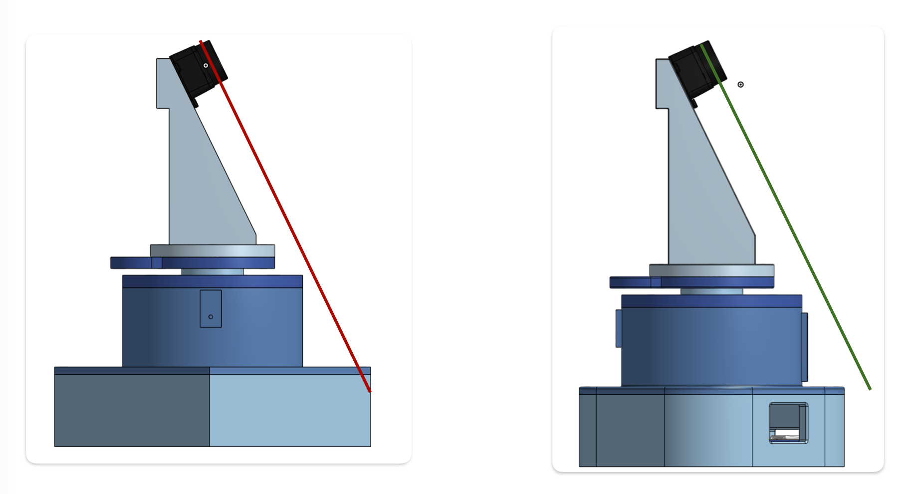
3D models/v1.1/v1.0 vs v1.1.png
