DarqSh/bap-novosad/defense_presentation/figures/Pokoj.png

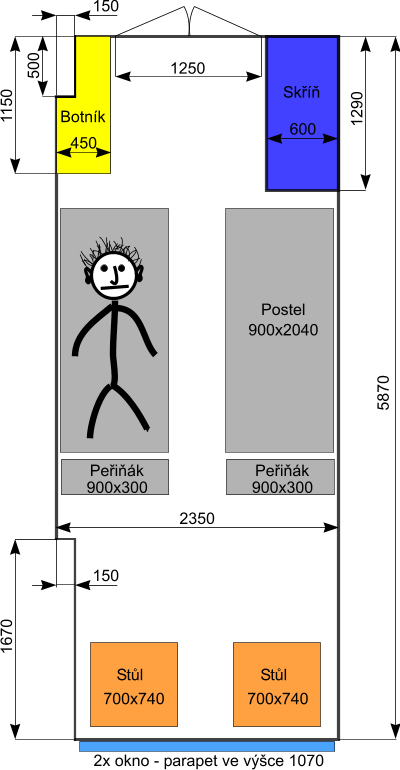
defense_presentation/figures/Pokoj.png
