DarqSh/bap-novosad/NSI/NSI_latex_submit/design/platform_showcase/platform_complete.png

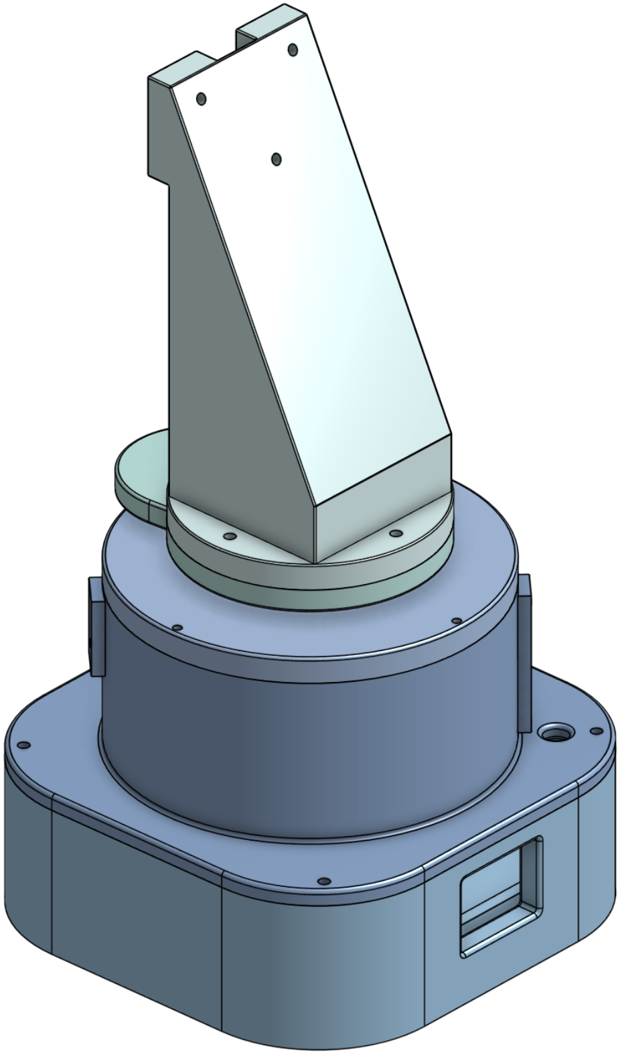
NSI/NSI_latex_submit/design/platform_showcase/platform_complete.png
