DarqSh/bap-novosad/NSI/NSI_latex_submit/electronics_software/electronic_design/drv_pinout.png

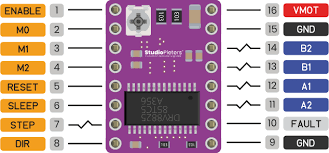
NSI/NSI_latex_submit/electronics_software/electronic_design/drv_pinout.png
