DarqSh/bap-novosad/NSI/NSI_presentation/figures/pcd_rotate_preview.png

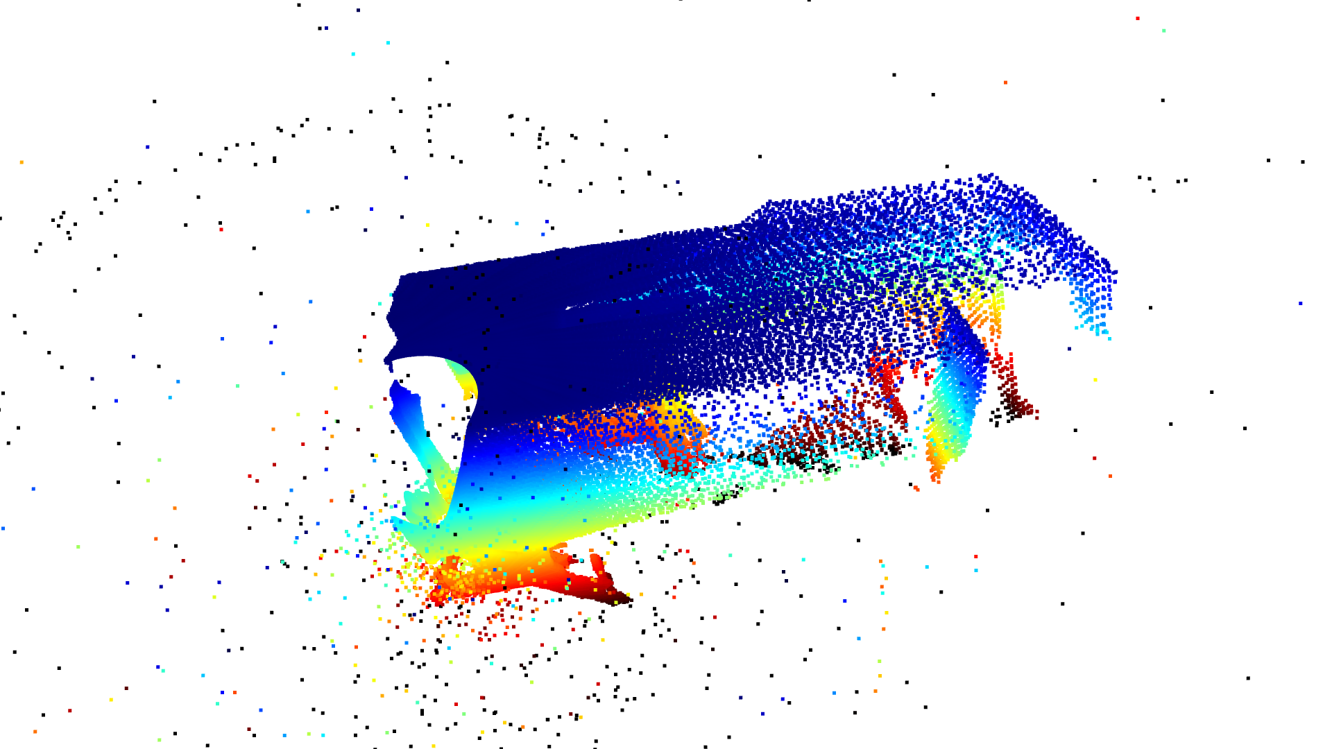
NSI/NSI_presentation/figures/pcd_rotate_preview.png
