DarqSh/bap-novosad/Point Cloud Distribution/1m0,1tol.png

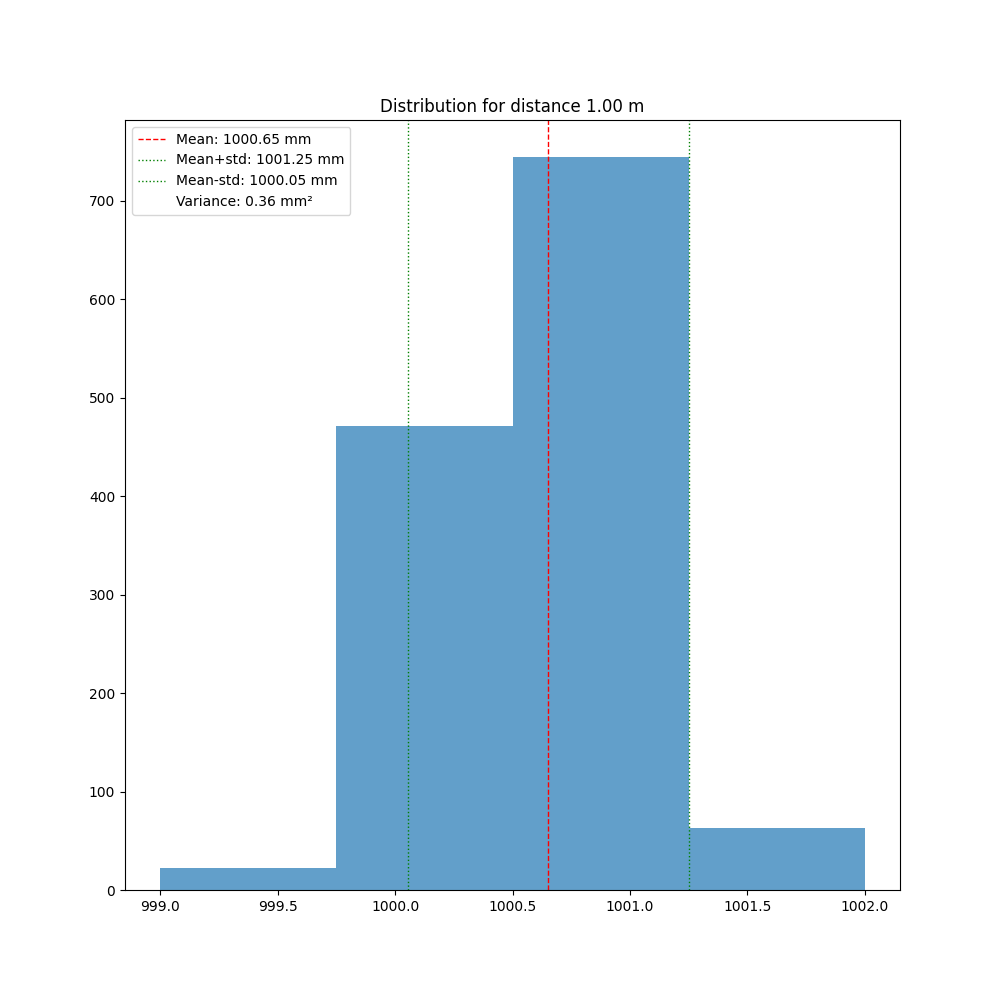
Point Cloud Distribution/1m0,1tol.png
