DarqSh/bap-novosad/Point Cloud Distribution/2m0,1tol.png

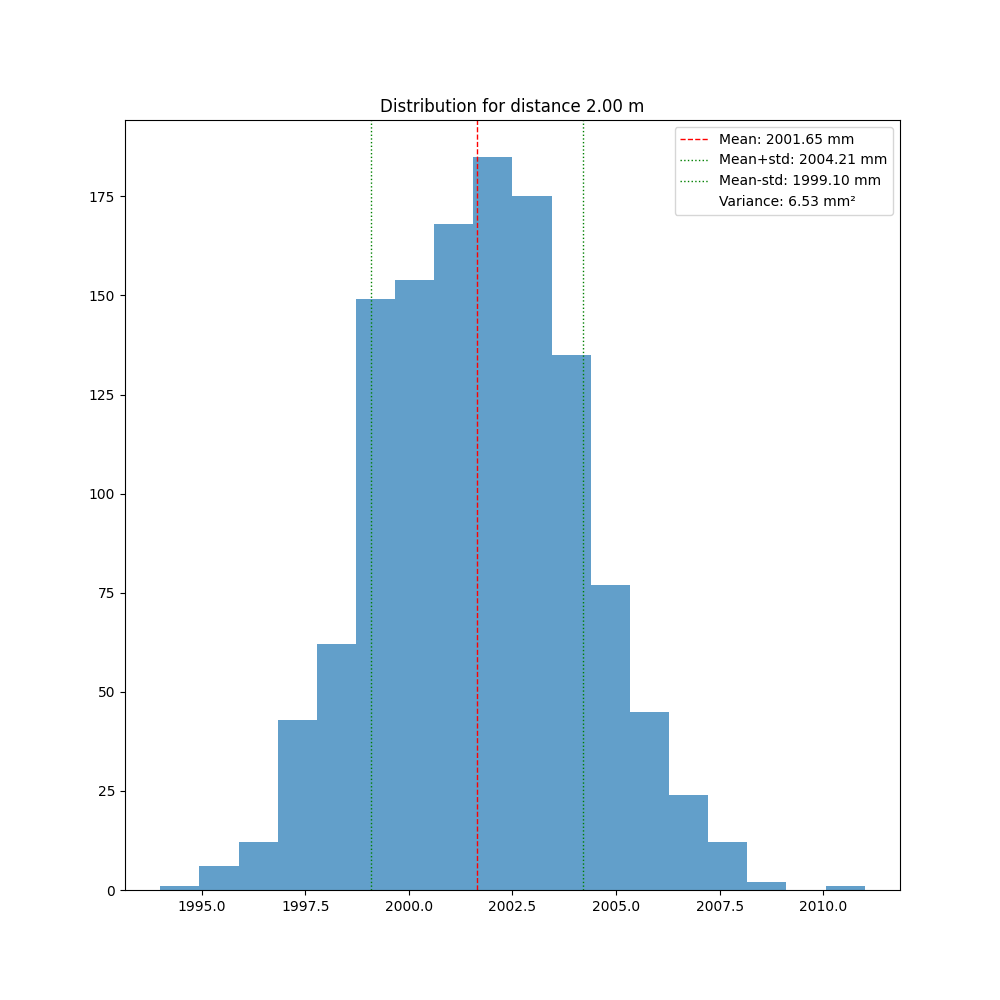
Point Cloud Distribution/2m0,1tol.png
