DarqSh/bap-novosad/Point Cloud Distribution/3m0,1tol.png

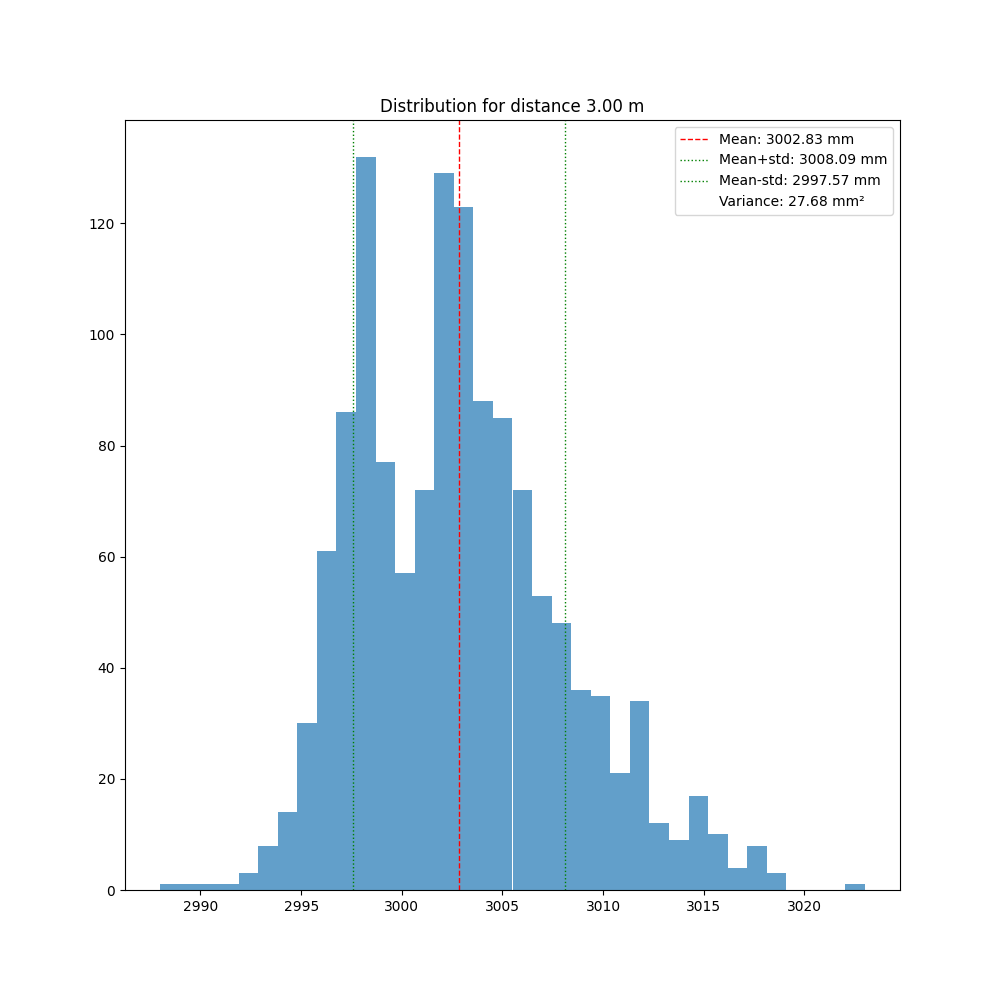
Point Cloud Distribution/3m0,1tol.png
