DarqSh/bap-novosad/Point Cloud Distribution/outlier_demo.png

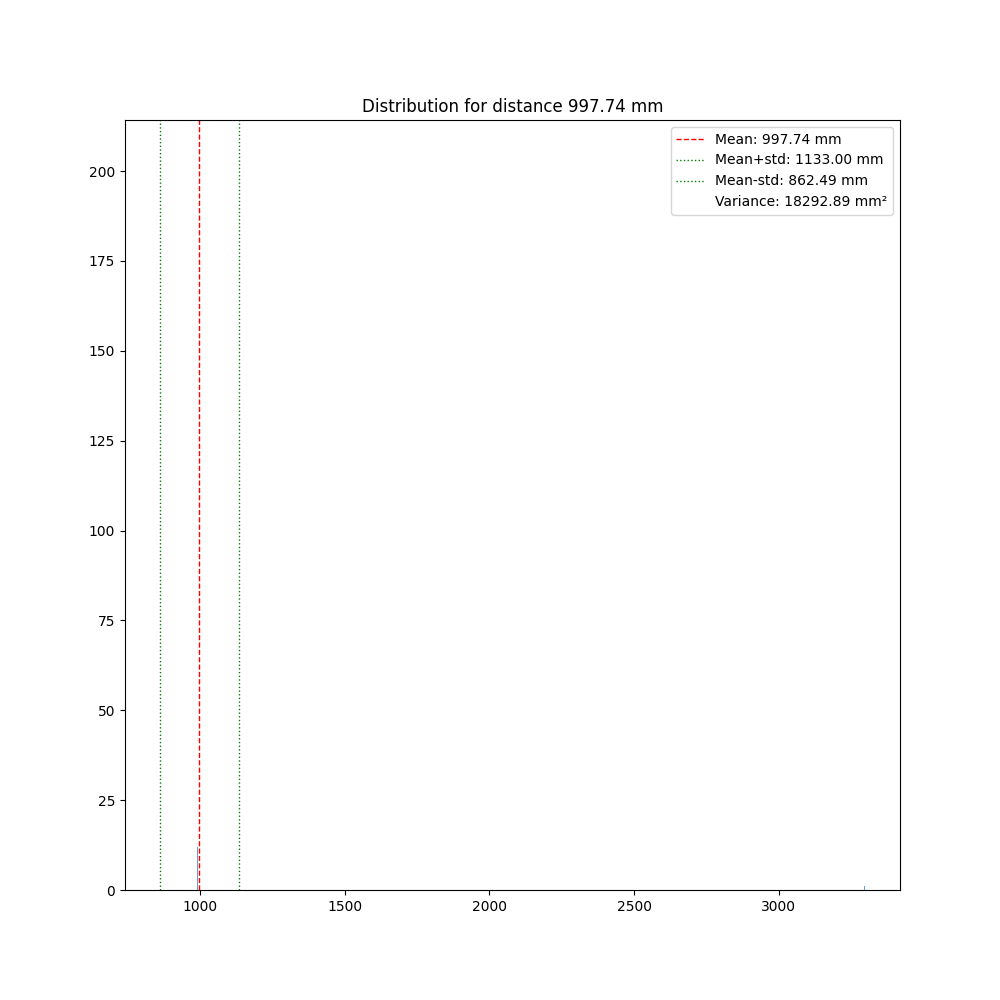
Point Cloud Distribution/outlier_demo.png
