DarqSh/bap-novosad/3D models/v1.1/DC housing.stl

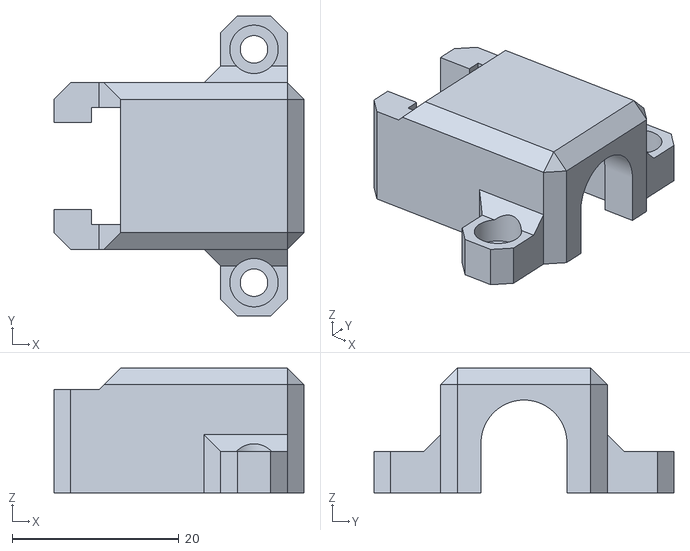
[picture p83: CAD file, 2026-03-24]
3D models/v1.1/DC housing.stl
30.0 x 36.0 x 15.0
