DarqSh/bap-novosad/3D models/v1.1/Lower Carrier.stl

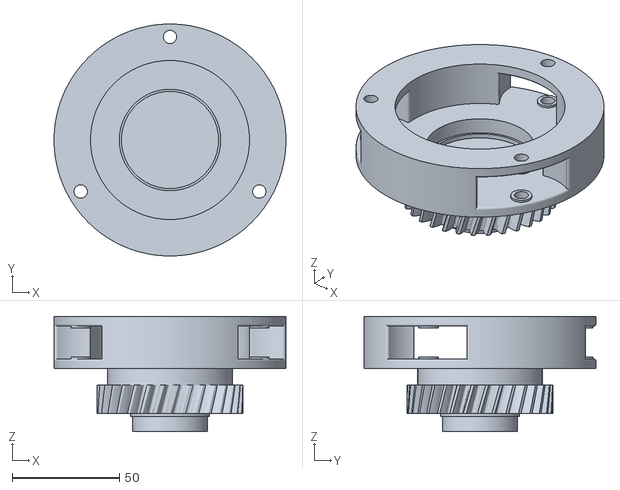
[picture p84: CAD file, 2026-03-24]
3D models/v1.1/Lower Carrier.stl
108.0 x 108.0 x 53.7
