DarqSh/bap-novosad/3D models/v1.1/Ring Gear Lid.stl

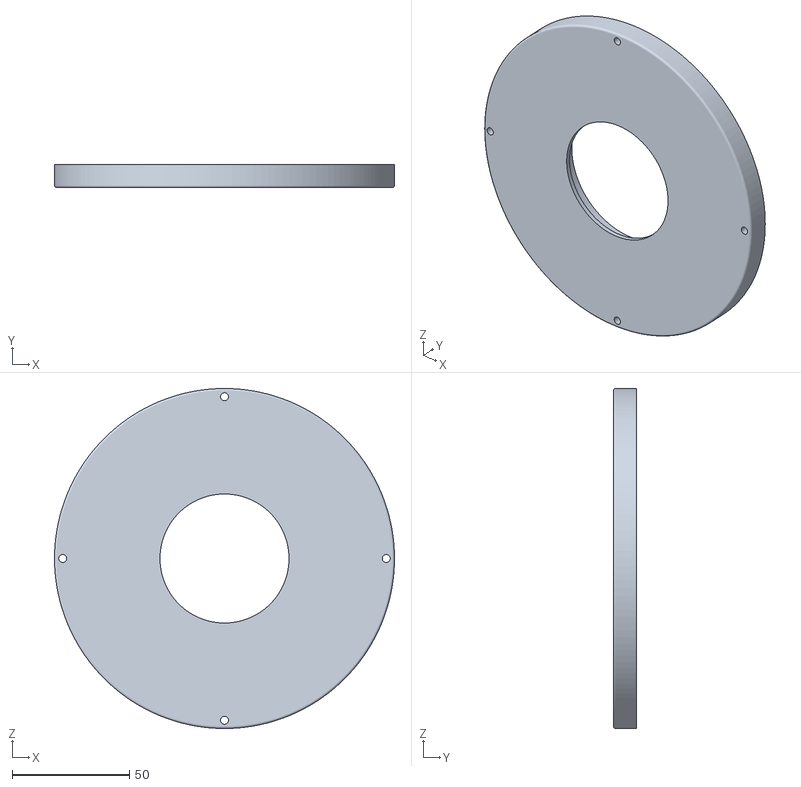
[picture p85: CAD file, 2026-03-24]
3D models/v1.1/Ring Gear Lid.stl
145.0 x 10.0 x 145.0
