DarqSh/bap-novosad/3D models/v1.1/Upper Carrier.stl

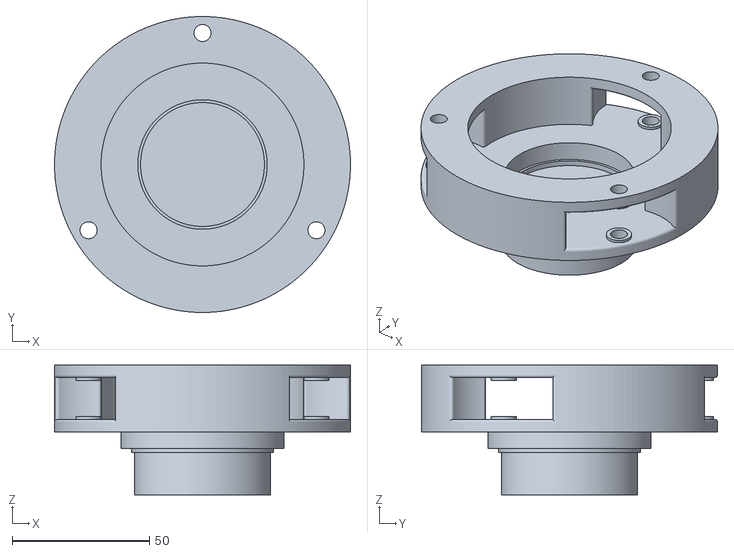
[picture p86: CAD file, 2026-03-24]
3D models/v1.1/Upper Carrier.stl
108.0 x 108.0 x 47.4
