DarqSh/bap-novosad/3D models/v1.1/Bottom.stl

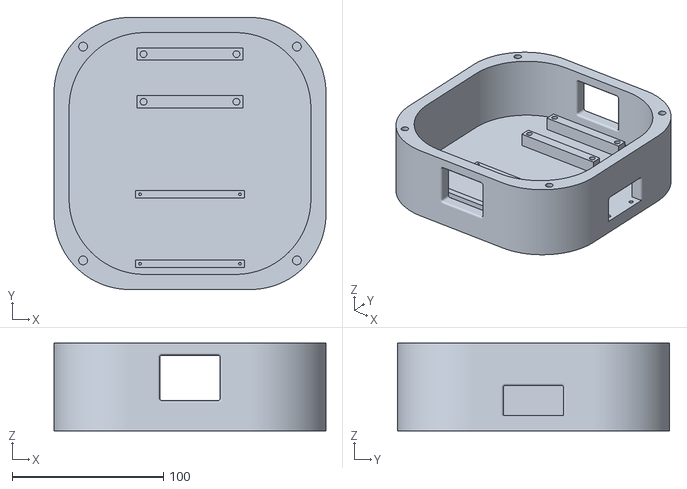
[picture p87: CAD file, 2026-03-24]
3D models/v1.1/Bottom.stl
180.0 x 180.0 x 58.0
