DarqSh/bap-novosad/3D models/v1.1/Platform Mount.stl

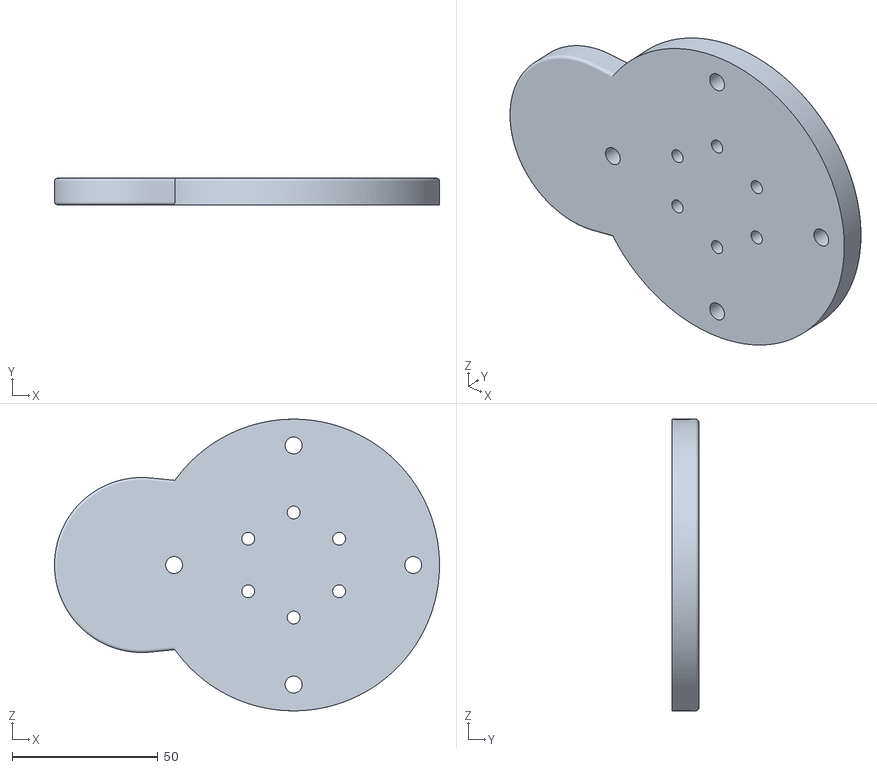
[picture p88: CAD file, 2026-03-24]
3D models/v1.1/Platform Mount.stl
132.0 x 9.10 x 100.0
