DarqSh/bap-novosad/3D models/v1.1/Platform.stl

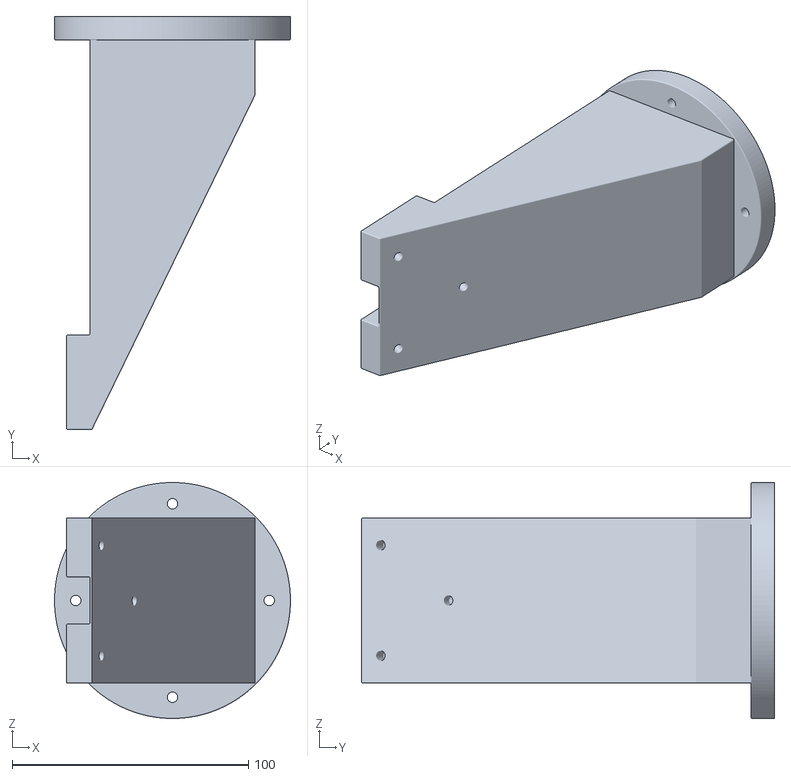
[picture p89: CAD file, 2026-03-24]
3D models/v1.1/Platform.stl
100.0 x 175.0 x 100.0
