DarqSh/bap-novosad/3D models/v1.1/CCW Gear x6.stl

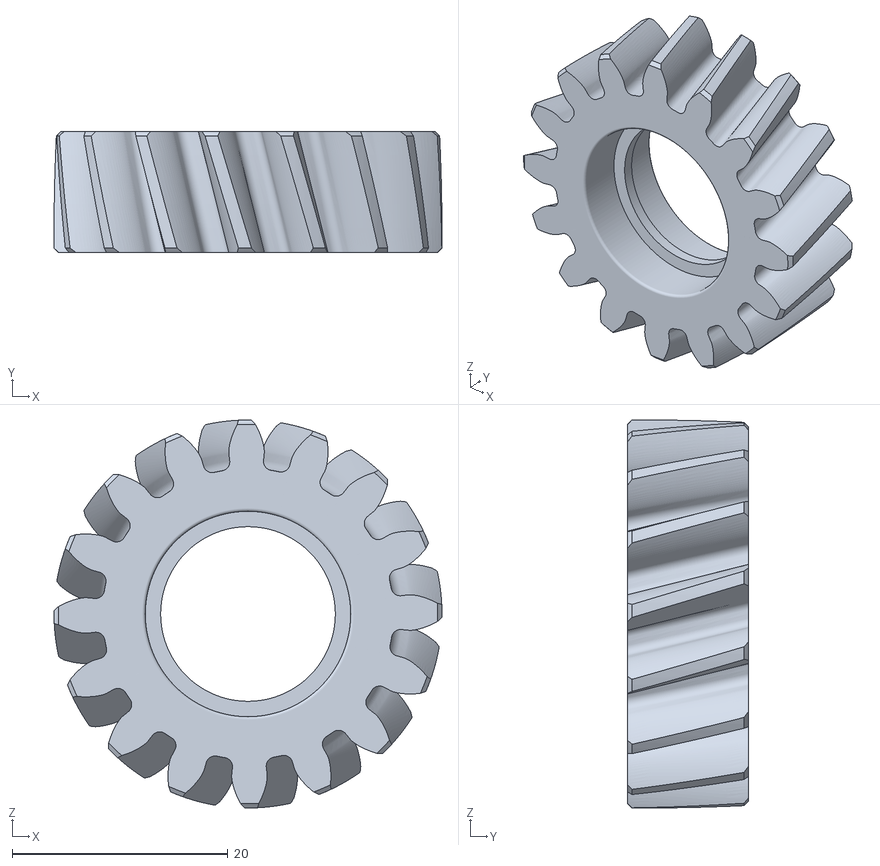
[picture p90: CAD file, 2026-03-24]
3D models/v1.1/CCW Gear x6.stl
36.0 x 11.2 x 36.0
