DarqSh/bap-novosad/3D models/v1.1/Motor Shaft Gear.stl

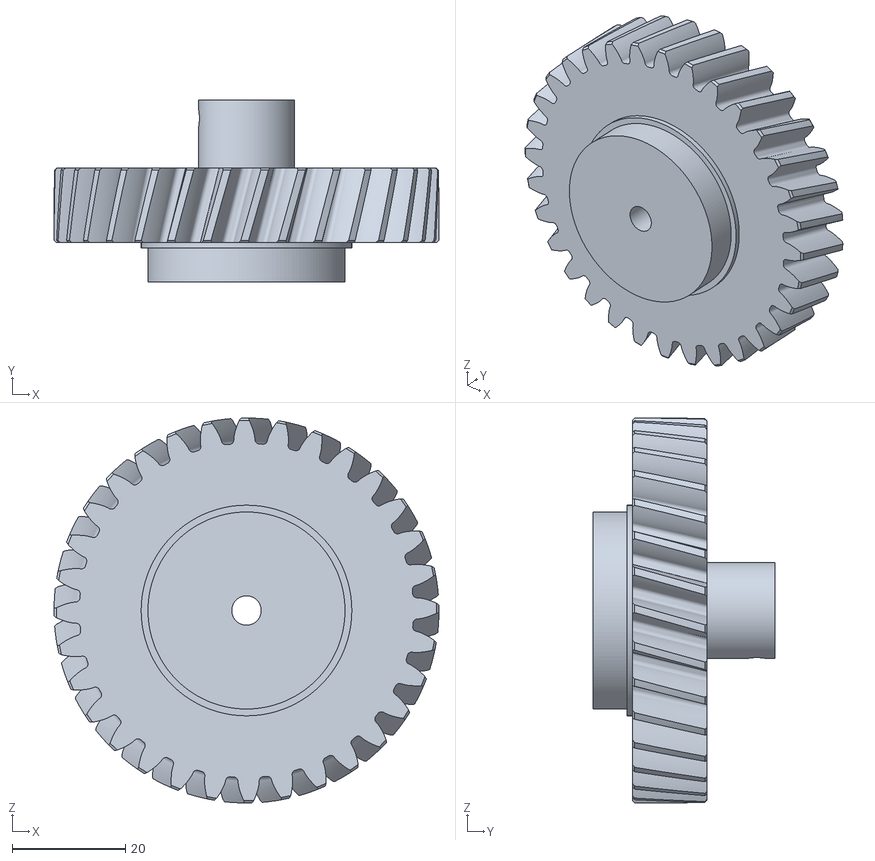
[picture p91: CAD file, 2026-03-18]
3D models/v1.1/Motor Shaft Gear.stl
68.0 x 32.2 x 68.0
