DarqSh/bap-novosad/3D models/v1.1/Rod x6.stl

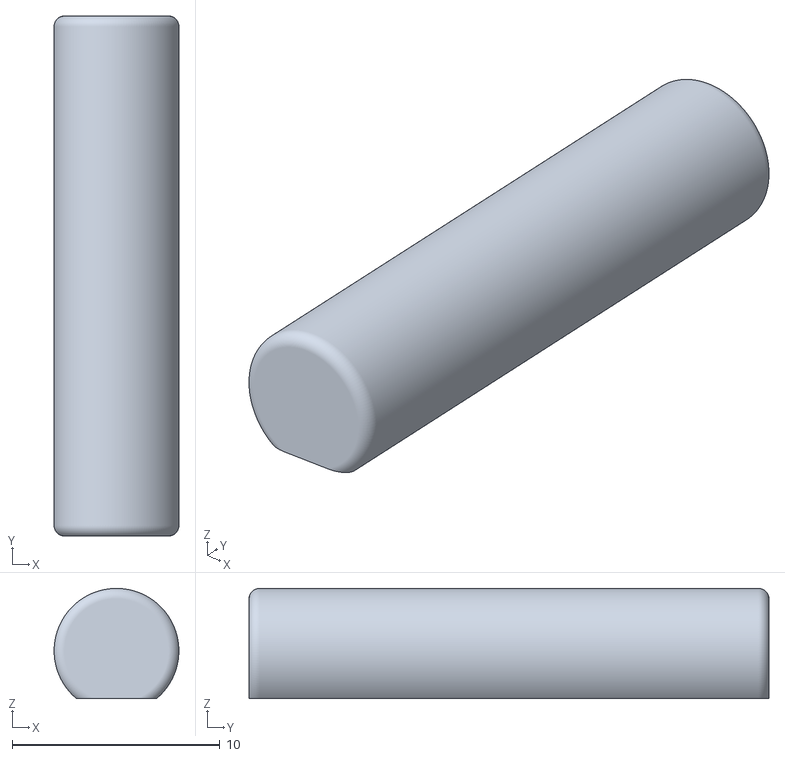
[picture p92: CAD file, 2026-03-18]
3D models/v1.1/Rod x6.stl
6.00 x 25.0 x 5.30
