DarqSh/bap-novosad/3D models/v1.0/Ring Gear Lid.stl

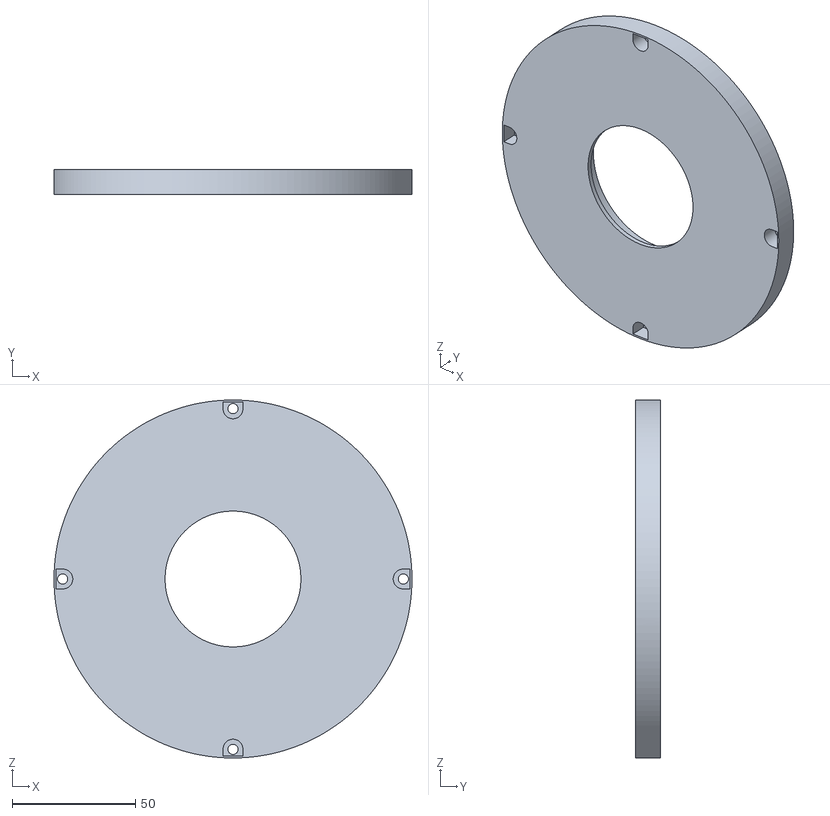
[picture p93: CAD file, 2026-03-18, an earlier design]
3D models/v1.0/Ring Gear Lid.stl
145.0 x 10.0 x 145.0
