DarqSh/bap-novosad/3D models/v1.0/Platform.stl

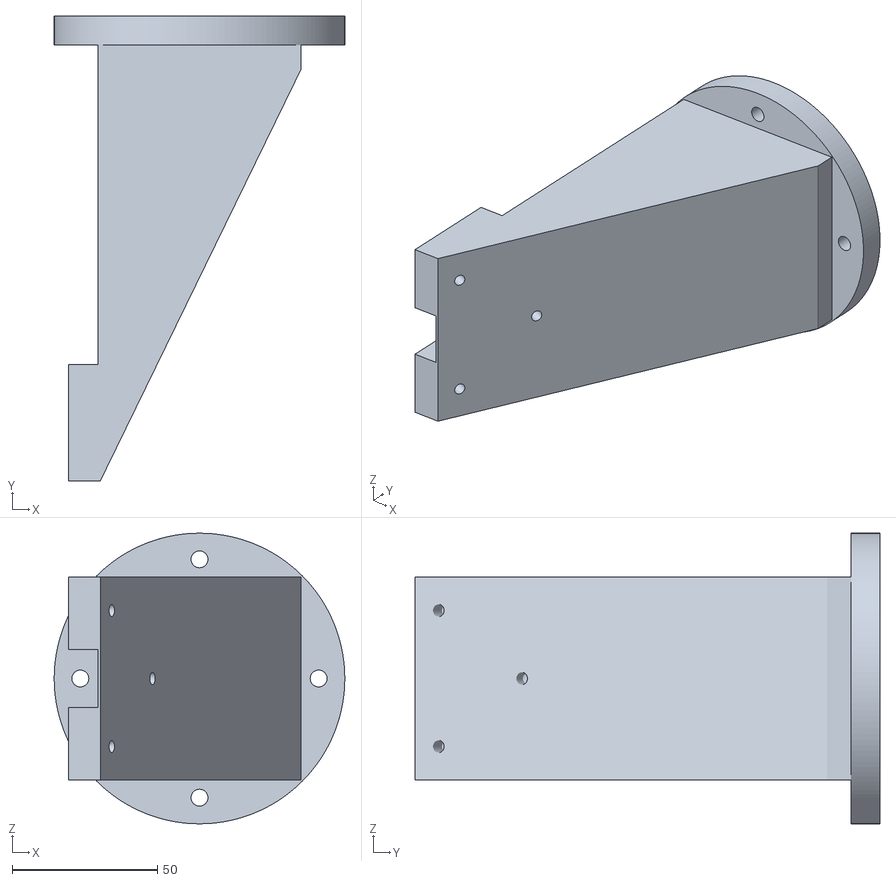
[picture p94: CAD file, 2026-03-18, an earlier design]
3D models/v1.0/Platform.stl
100.0 x 160.0 x 100.0
