DarqSh/bap-novosad/3D models/v1.0/Platform Mount.stl

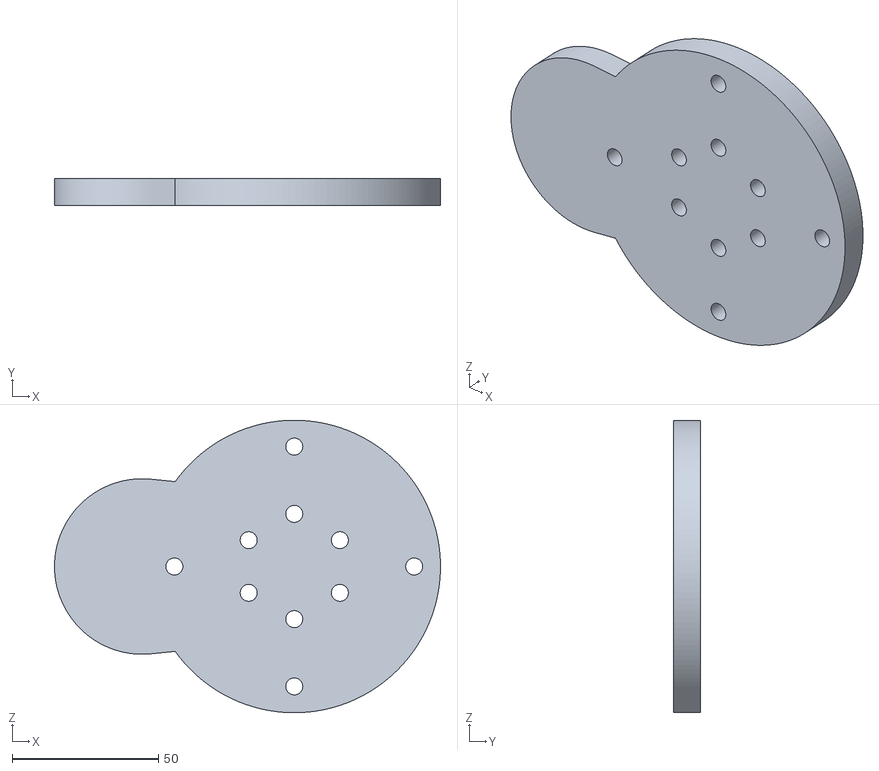
[picture p95: CAD file, 2026-03-18, an earlier design]
3D models/v1.0/Platform Mount.stl
132.0 x 9.10 x 100.0
