DarqSh/bap-novosad/3D models/v1.0/Bottom.stl

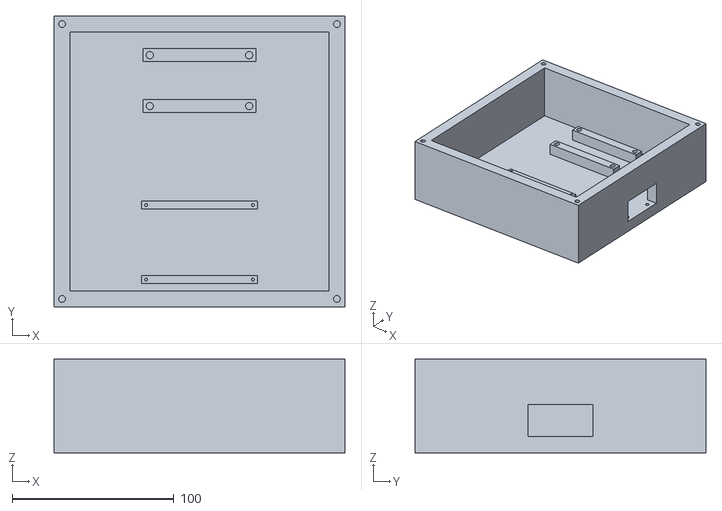
[picture p96: CAD file, 2026-03-18, an earlier design]
3D models/v1.0/Bottom.stl
180.0 x 180.0 x 58.0
