DarqSh/bap-novosad/(list of files, cad)

Other CAD files:
code/align_demo/pcd_2026.06.02_20:37:36_263845_ransacalign.ply
code/distance_measurement/pcd_2026.06.01_16:51:32_263851_source.ply
code/align_demo/pcd_2026.06.01_16:53:58_264111_smallrotate.ply
code/align_demo/pcd_2026.06.01_19:56:44_264167_ransacalign.ply
3D models/v1.0/DC housing.stl
3D models/v1.0/Gear CCW x6.stl
3D models/v1.0/Lower Carrier.stl
3D models/v1.0/Upper Carrier.stl
