DarqSh/bap-novosad/AngleRes (Tilt, Step)/angleRes_TiltOnly.tex

% This file was created by matlab2tikz.
%
%The latest updates can be retrieved from
%  http://www.mathworks.com/matlabcentral/fileexchange/22022-matlab2tikz-matlab2tikz
%where you can also make suggestions and rate matlab2tikz.
%
\begin{tikzpicture}

\begin{axis}[%
width=5.965in,
height=4.421in,
at={(1.074in,0.975in)},
scale only axis,
xmin=0,
xmax=80,
xlabel style={font=\color{white!15!black}},
xlabel={$\text{Tilt angle }\theta$},
ymin=0,
ymax=2,
ylabel style={font=\color{white!15!black}},
ylabel={Resolution between steps},
axis background/.style={fill=white},
xmajorgrids,
ymajorgrids,
legend style={at={(0.03,0.97)}, anchor=north west, legend cell align=left, align=left, draw=white!15!black}
]
\addplot [color=blue, line width=1.0pt]
  table[row sep=crcr]{%
10	0.312566719800475\\
10.7070707070707	0.334418175694128\\
11.4141414141414	0.356218702630123\\
12.1212121212121	0.377964980579247\\
12.8282828282828	0.39965369777393\\
13.5353535353535	0.4212815512126\\
14.2424242424242	0.442845247162704\\
14.9494949494949	0.464341501662311\\
15.6565656565657	0.485767041020232\\
16.3636363636364	0.507118602314573\\
17.0707070707071	0.528392933889655\\
17.7777777777778	0.549586795851204\\
18.4848484848485	0.570696960559764\\
19.1919191919192	0.59172021312224\\
19.8989898989899	0.612653351881492\\
20.6060606060606	0.633493188903923\\
21.3131313131313	0.654236550464975\\
22.020202020202	0.674880277532455\\
22.7272727272727	0.695421226247632\\
23.4343434343434	0.715856268404016\\
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
  table[row sep=crcr]{%
23.4343434343434	0.715856268404016\\
};
\node[right, align=left, inner sep=0]
at (axis cs:25.934,0.766) {$\text{(23.4}^\circ\text{, 0.72}^\circ\text{)}$};
\end{axis}
\end{tikzpicture}%
