DarqSh/bap-novosad/AngleRes (Tilt, Step)/AngleRes_calculation.pdf

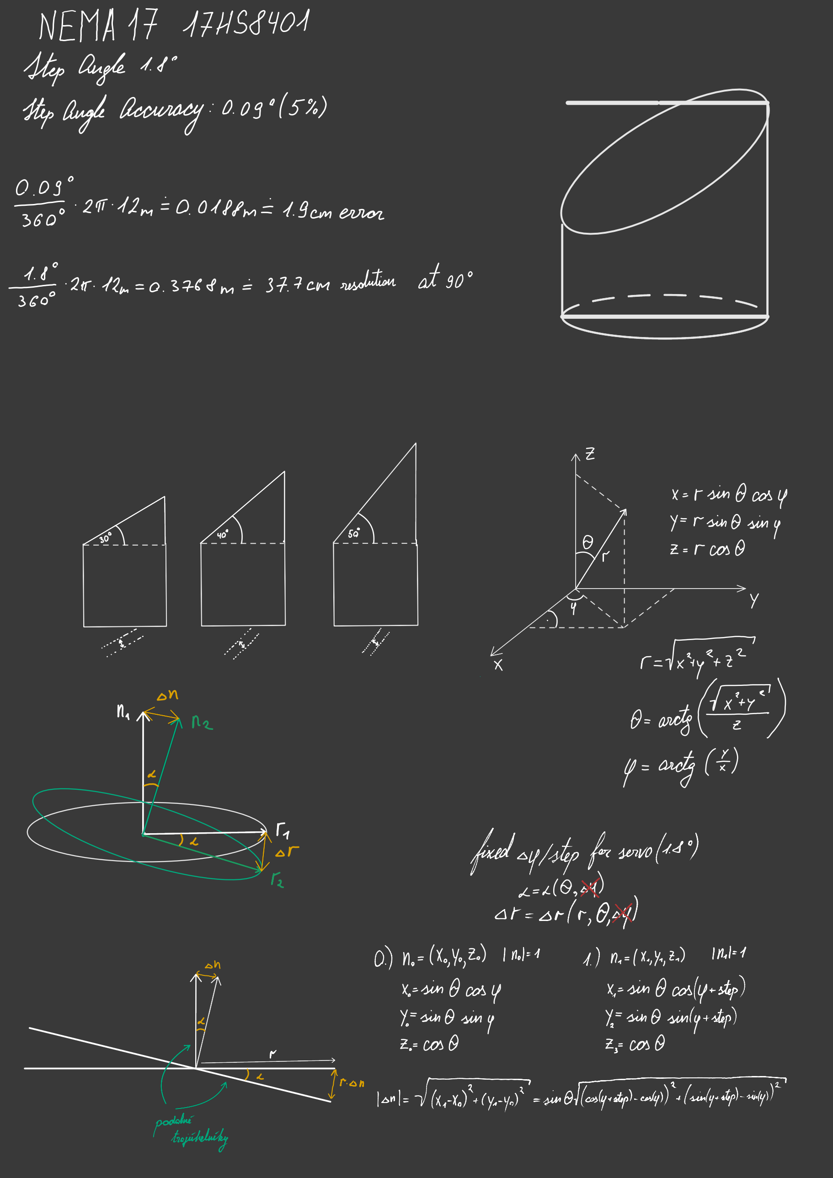
[picture p97: page 1]
