DarqSh/bap-novosad/AngleRes (Tilt, Step)/graph_angleResTiltOnly.png

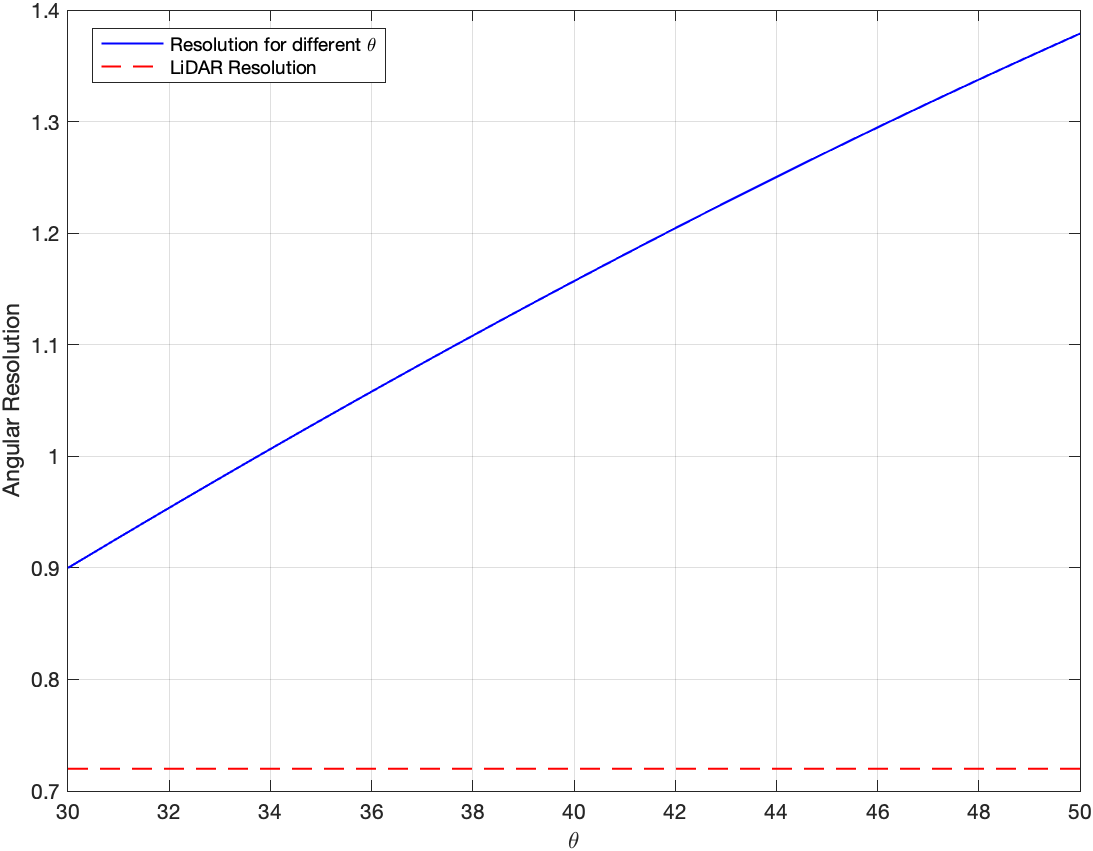
AngleRes (Tilt, Step)/graph_angleResTiltOnly.png
