DarqSh/bap-novosad/AngleRes (Tilt, Step)/graph_angleResTiltPlusGearbox.png

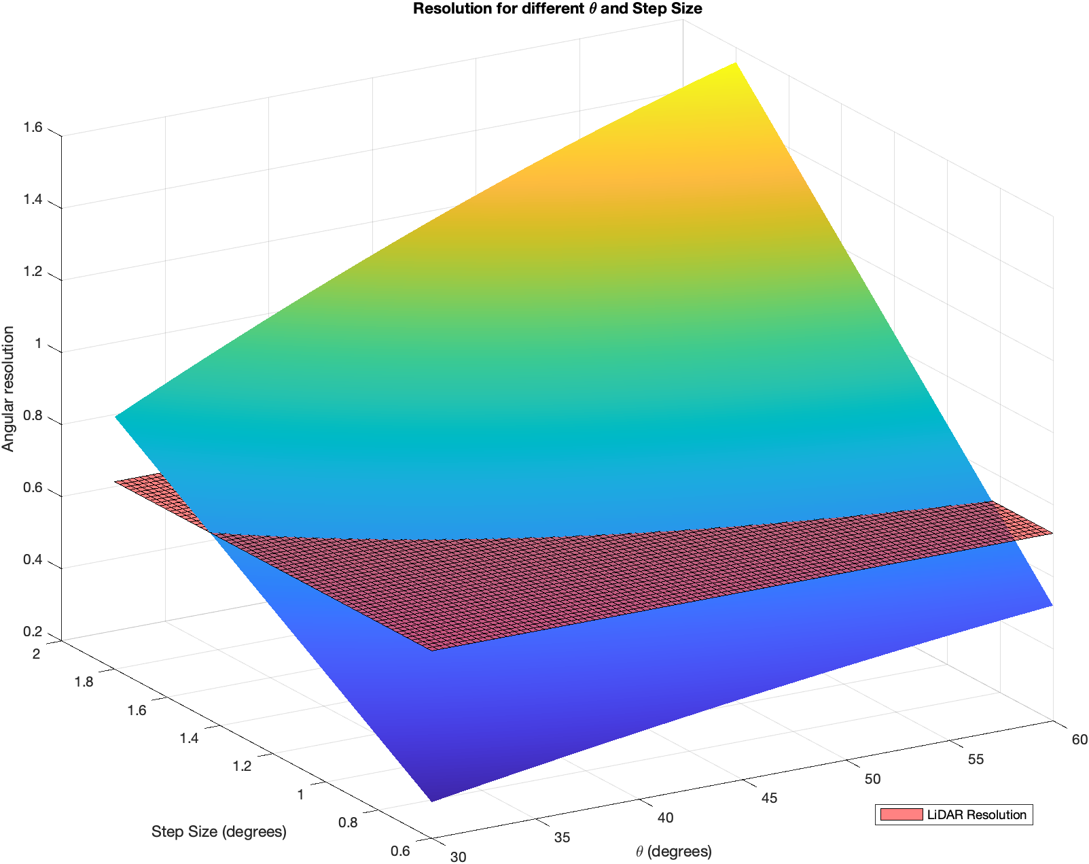
AngleRes (Tilt, Step)/graph_angleResTiltPlusGearbox.png
