DarqSh/bap-novosad/AngleRes (Tilt, Step)/suggested_angles.png

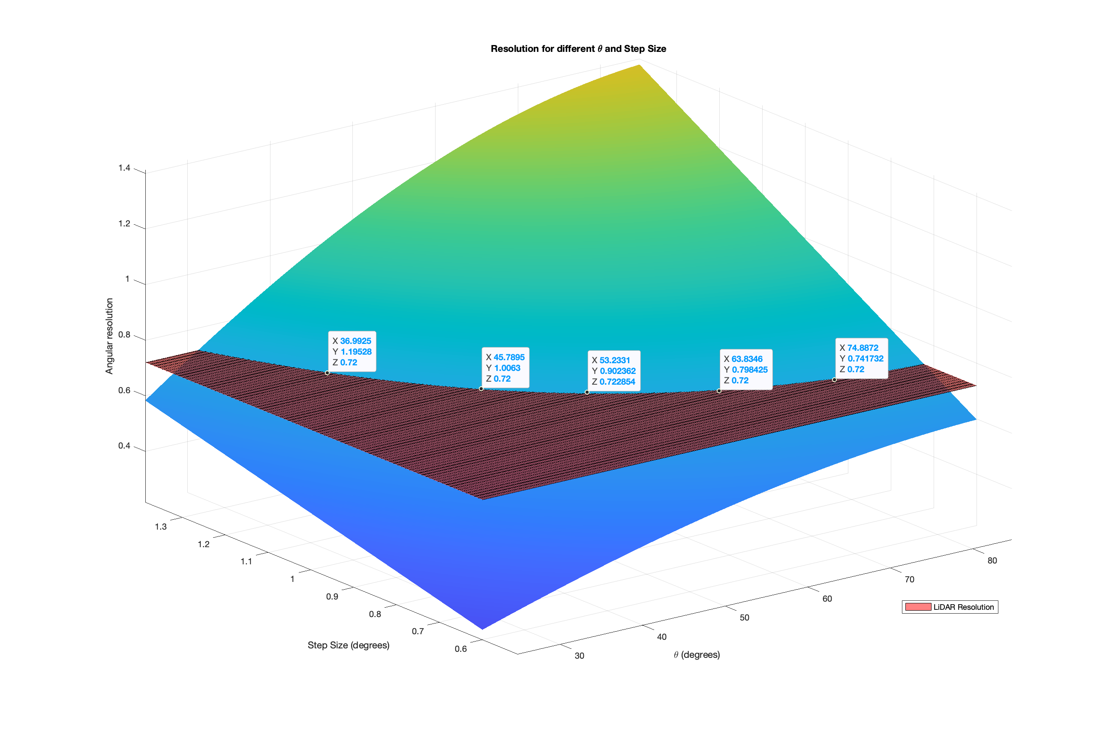
AngleRes (Tilt, Step)/suggested_angles.png
