DarqSh/bap-novosad/Point Cloud Distribution/3m_MeasurementSetup.jpg

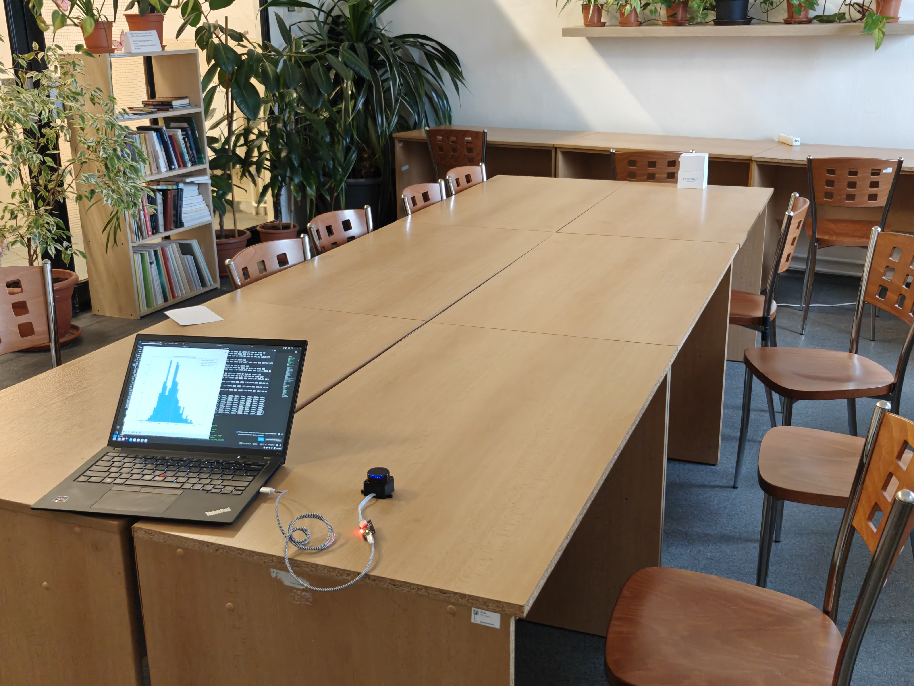
Point Cloud Distribution/3m_MeasurementSetup.jpg
