DarqSh/bap-novosad/AngleRes (Tilt, Step)/test.tex

% This file was created by matlab2tikz.
%
%The latest updates can be retrieved from
%  http://www.mathworks.com/matlabcentral/fileexchange/22022-matlab2tikz-matlab2tikz
%where you can also make suggestions and rate matlab2tikz.
%
\begin{tikzpicture}

\begin{axis}[%
width=6.028in,
height=4.754in,
at={(1.011in,0.642in)},
scale only axis,
xmin=30,
xmax=80,
tick align=outside,
xlabel style={font=\color{white!15!black}},
xlabel={$\theta$ [$\deg$]},
ymin=0.6,
ymax=1.4,
ylabel style={font=\color{white!15!black}},
ylabel={Step size [$\deg$]},
zmin=0.2,
zmax=1.4,
zlabel style={font=\color{white!15!black}},
zlabel={Angular resolution [$\deg$]},
view={-37.5}{30},
axis background/.style={fill=white},
axis x line*=bottom,
axis y line*=left,
axis z line*=left,
xmajorgrids,
ymajorgrids,
zmajorgrids,
legend style={at={(0.03,0.97)}, anchor=north west, legend cell align=left, align=left, draw=white!15!black}
]

\addplot3[%
surf,
shader=interp, colormap={mymap}{[1pt] rgb(0pt)=(0.2422,0.1504,0.6603); rgb(1pt)=(0.2444,0.1534,0.6728); rgb(2pt)=(0.2464,0.1569,0.6847); rgb(3pt)=(0.2484,0.1607,0.6961); rgb(4pt)=(0.2503,0.1648,0.7071); rgb(5pt)=(0.2522,0.1689,0.7179); rgb(6pt)=(0.254,0.1732,0.7286); rgb(7pt)=(0.2558,0.1773,0.7393); rgb(8pt)=(0.2576,0.1814,0.7501); rgb(9pt)=(0.2594,0.1854,0.761); rgb(11pt)=(0.2628,0.1932,0.7828); rgb(12pt)=(0.2645,0.1972,0.7937); rgb(13pt)=(0.2661,0.2011,0.8043); rgb(14pt)=(0.2676,0.2052,0.8148); rgb(15pt)=(0.2691,0.2094,0.8249); rgb(16pt)=(0.2704,0.2138,0.8346); rgb(17pt)=(0.2717,0.2184,0.8439); rgb(18pt)=(0.2729,0.2231,0.8528); rgb(19pt)=(0.274,0.228,0.8612); rgb(20pt)=(0.2749,0.233,0.8692); rgb(21pt)=(0.2758,0.2382,0.8767); rgb(22pt)=(0.2766,0.2435,0.884); rgb(23pt)=(0.2774,0.2489,0.8908); rgb(24pt)=(0.2781,0.2543,0.8973); rgb(25pt)=(0.2788,0.2598,0.9035); rgb(26pt)=(0.2794,0.2653,0.9094); rgb(27pt)=(0.2798,0.2708,0.915); rgb(28pt)=(0.2802,0.2764,0.9204); rgb(29pt)=(0.2806,0.2819,0.9255); rgb(30pt)=(0.2809,0.2875,0.9305); rgb(31pt)=(0.2811,0.293,0.9352); rgb(32pt)=(0.2813,0.2985,0.9397); rgb(33pt)=(0.2814,0.304,0.9441); rgb(34pt)=(0.2814,0.3095,0.9483); rgb(35pt)=(0.2813,0.315,0.9524); rgb(36pt)=(0.2811,0.3204,0.9563); rgb(37pt)=(0.2809,0.3259,0.96); rgb(38pt)=(0.2807,0.3313,0.9636); rgb(39pt)=(0.2803,0.3367,0.967); rgb(40pt)=(0.2798,0.3421,0.9702); rgb(41pt)=(0.2791,0.3475,0.9733); rgb(42pt)=(0.2784,0.3529,0.9763); rgb(43pt)=(0.2776,0.3583,0.9791); rgb(44pt)=(0.2766,0.363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
30	1.04444444444444	0.522222222222222	0.522222222222222\\
30	1.05714285714286	0.528571428571428	0.528571428571428\\
30	1.06984126984127	0.534920634920635	0.534920634920635\\
30	1.08253968253968	0.541269841269841	0.541269841269841\\
30	1.0952380952381	0.547619047619047	0.547619047619047\\
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
