DarqSh/bap-novosad/defense_presentation/figures/results/whole_room.png

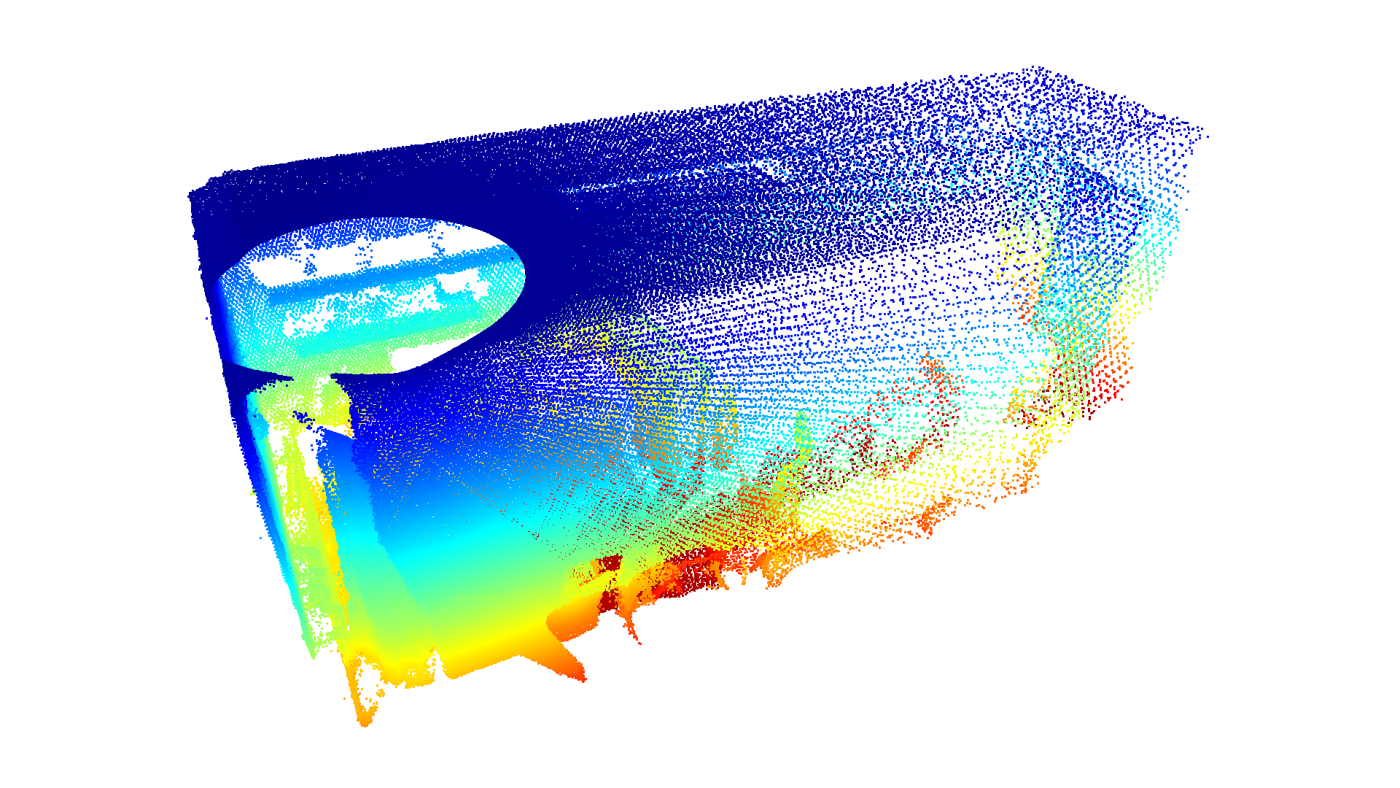
defense_presentation/figures/results/whole_room.png
