DarqSh/bap-novosad/defense_presentation/figures/results/z_bad_ceiling_color.png

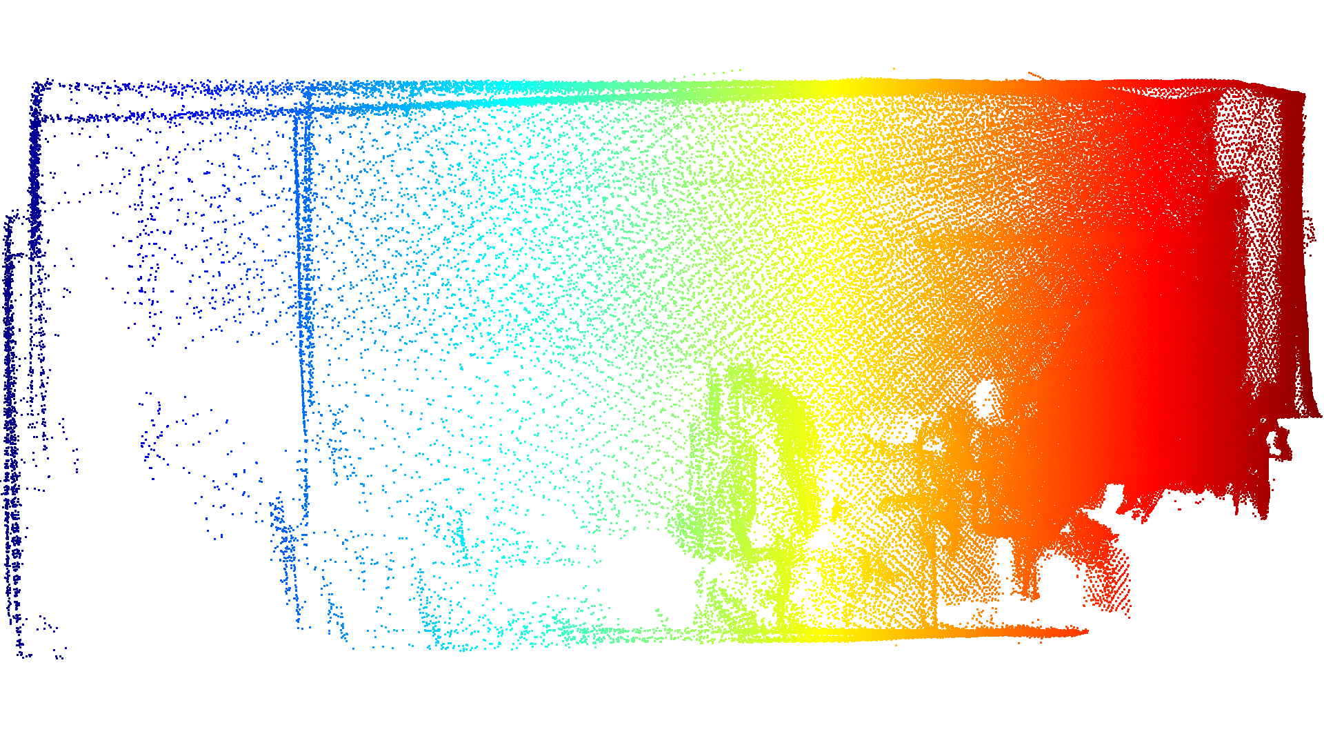
defense_presentation/figures/results/z_bad_ceiling_color.png
