DarqSh/bap-novosad/defense_presentation/figures/results/z_bad_wall_color.png

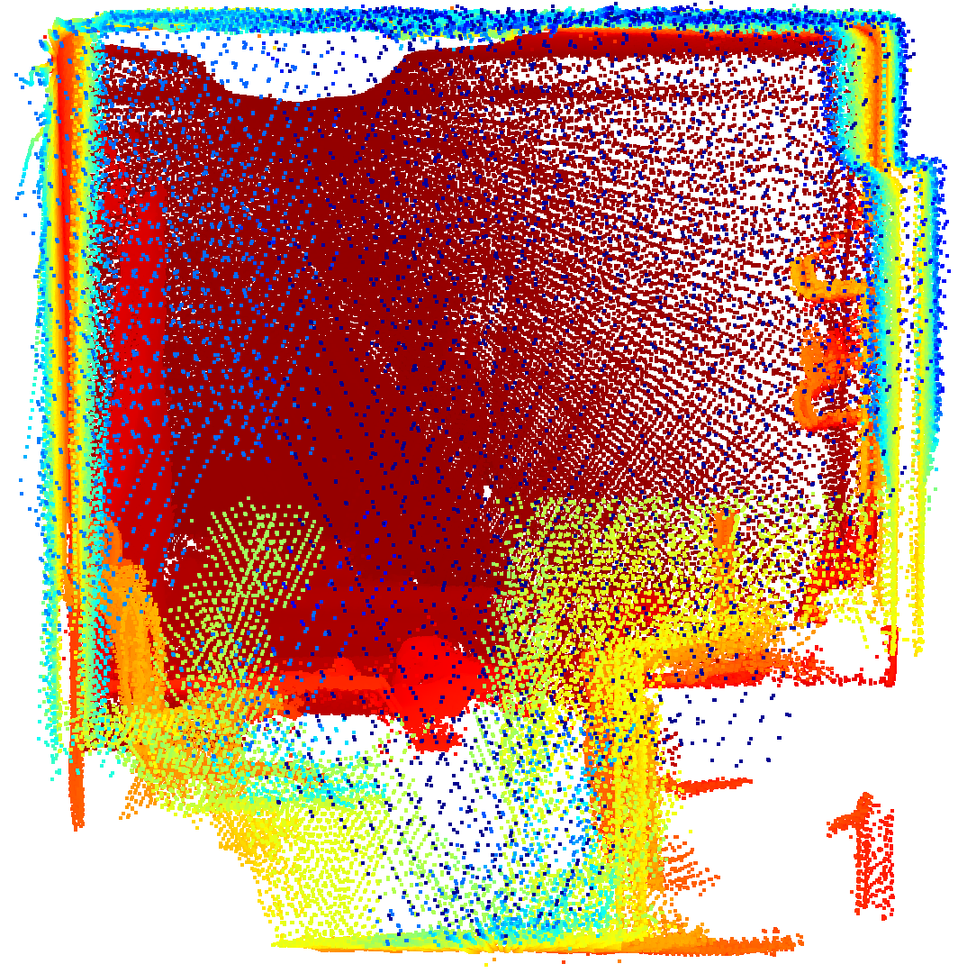
defense_presentation/figures/results/z_bad_wall_color.png
