DarqSh/bap-novosad/NSI/NSI_presentation/figures/results/flask_photo.png

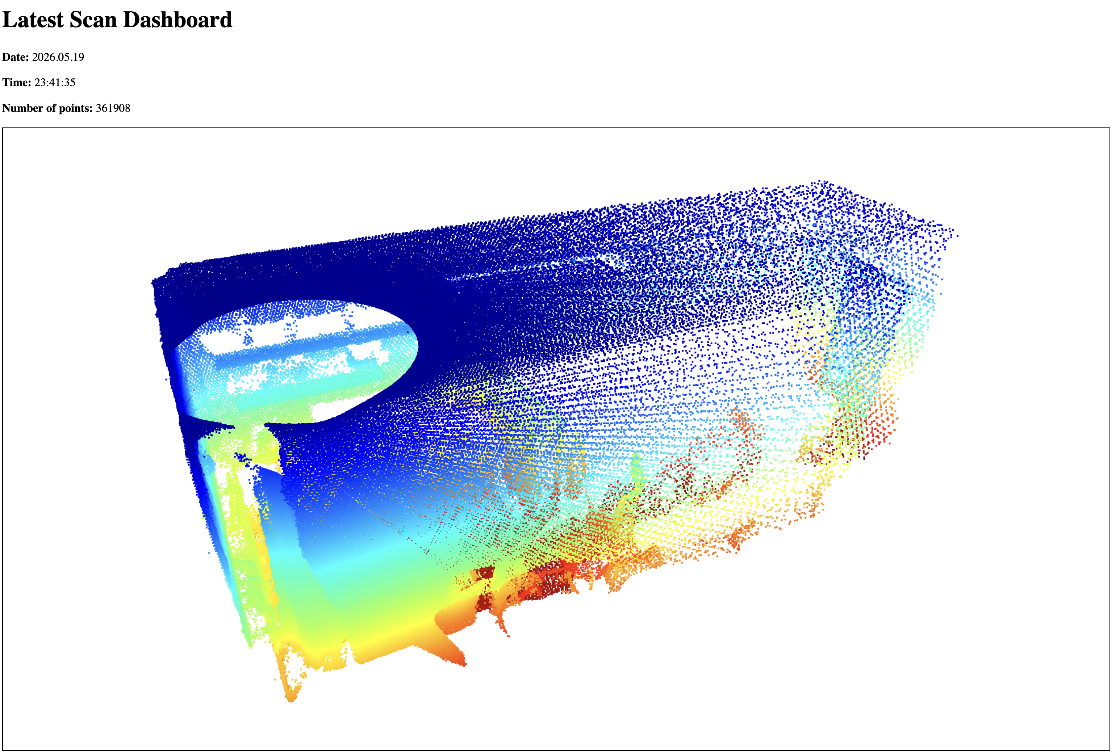
NSI/NSI_presentation/figures/results/flask_photo.png
