DarqSh/bap-novosad/AngleRes (Tilt, Step)/test.pdf

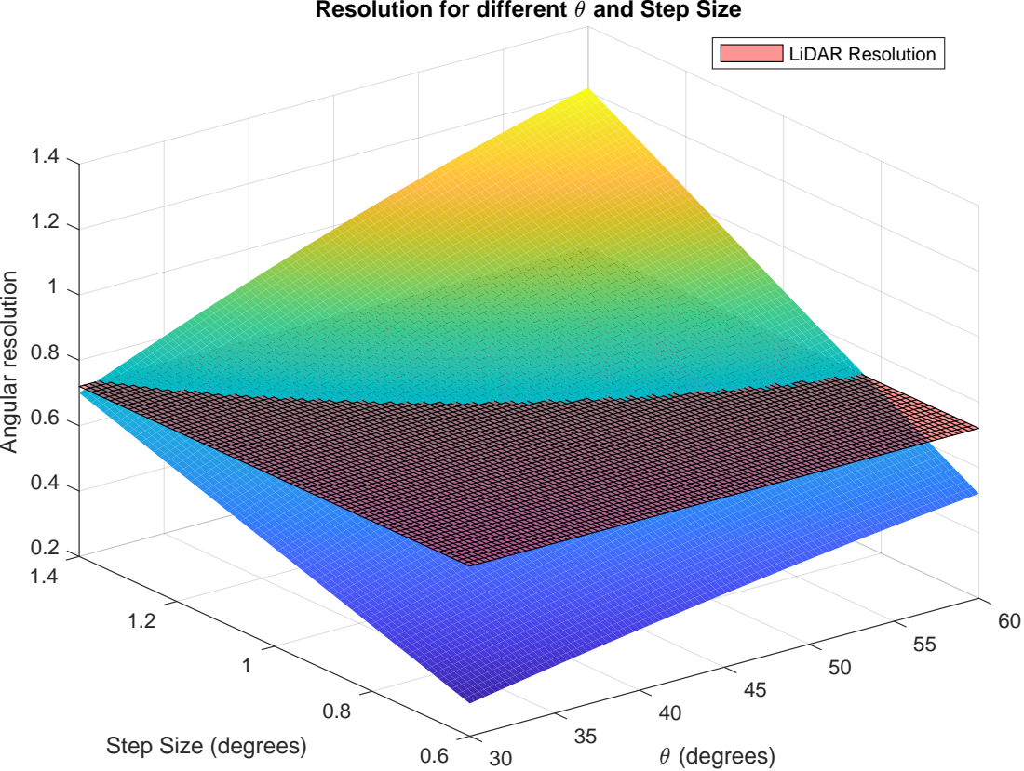
[picture p108: page 1]
Angular resolution; 3 (degrees); LiDAR Resolution

Resolution for different 3 and Step Size

Step Size (degrees)
