DarqSh/bap-novosad/maluvky/wiring_1.pdf

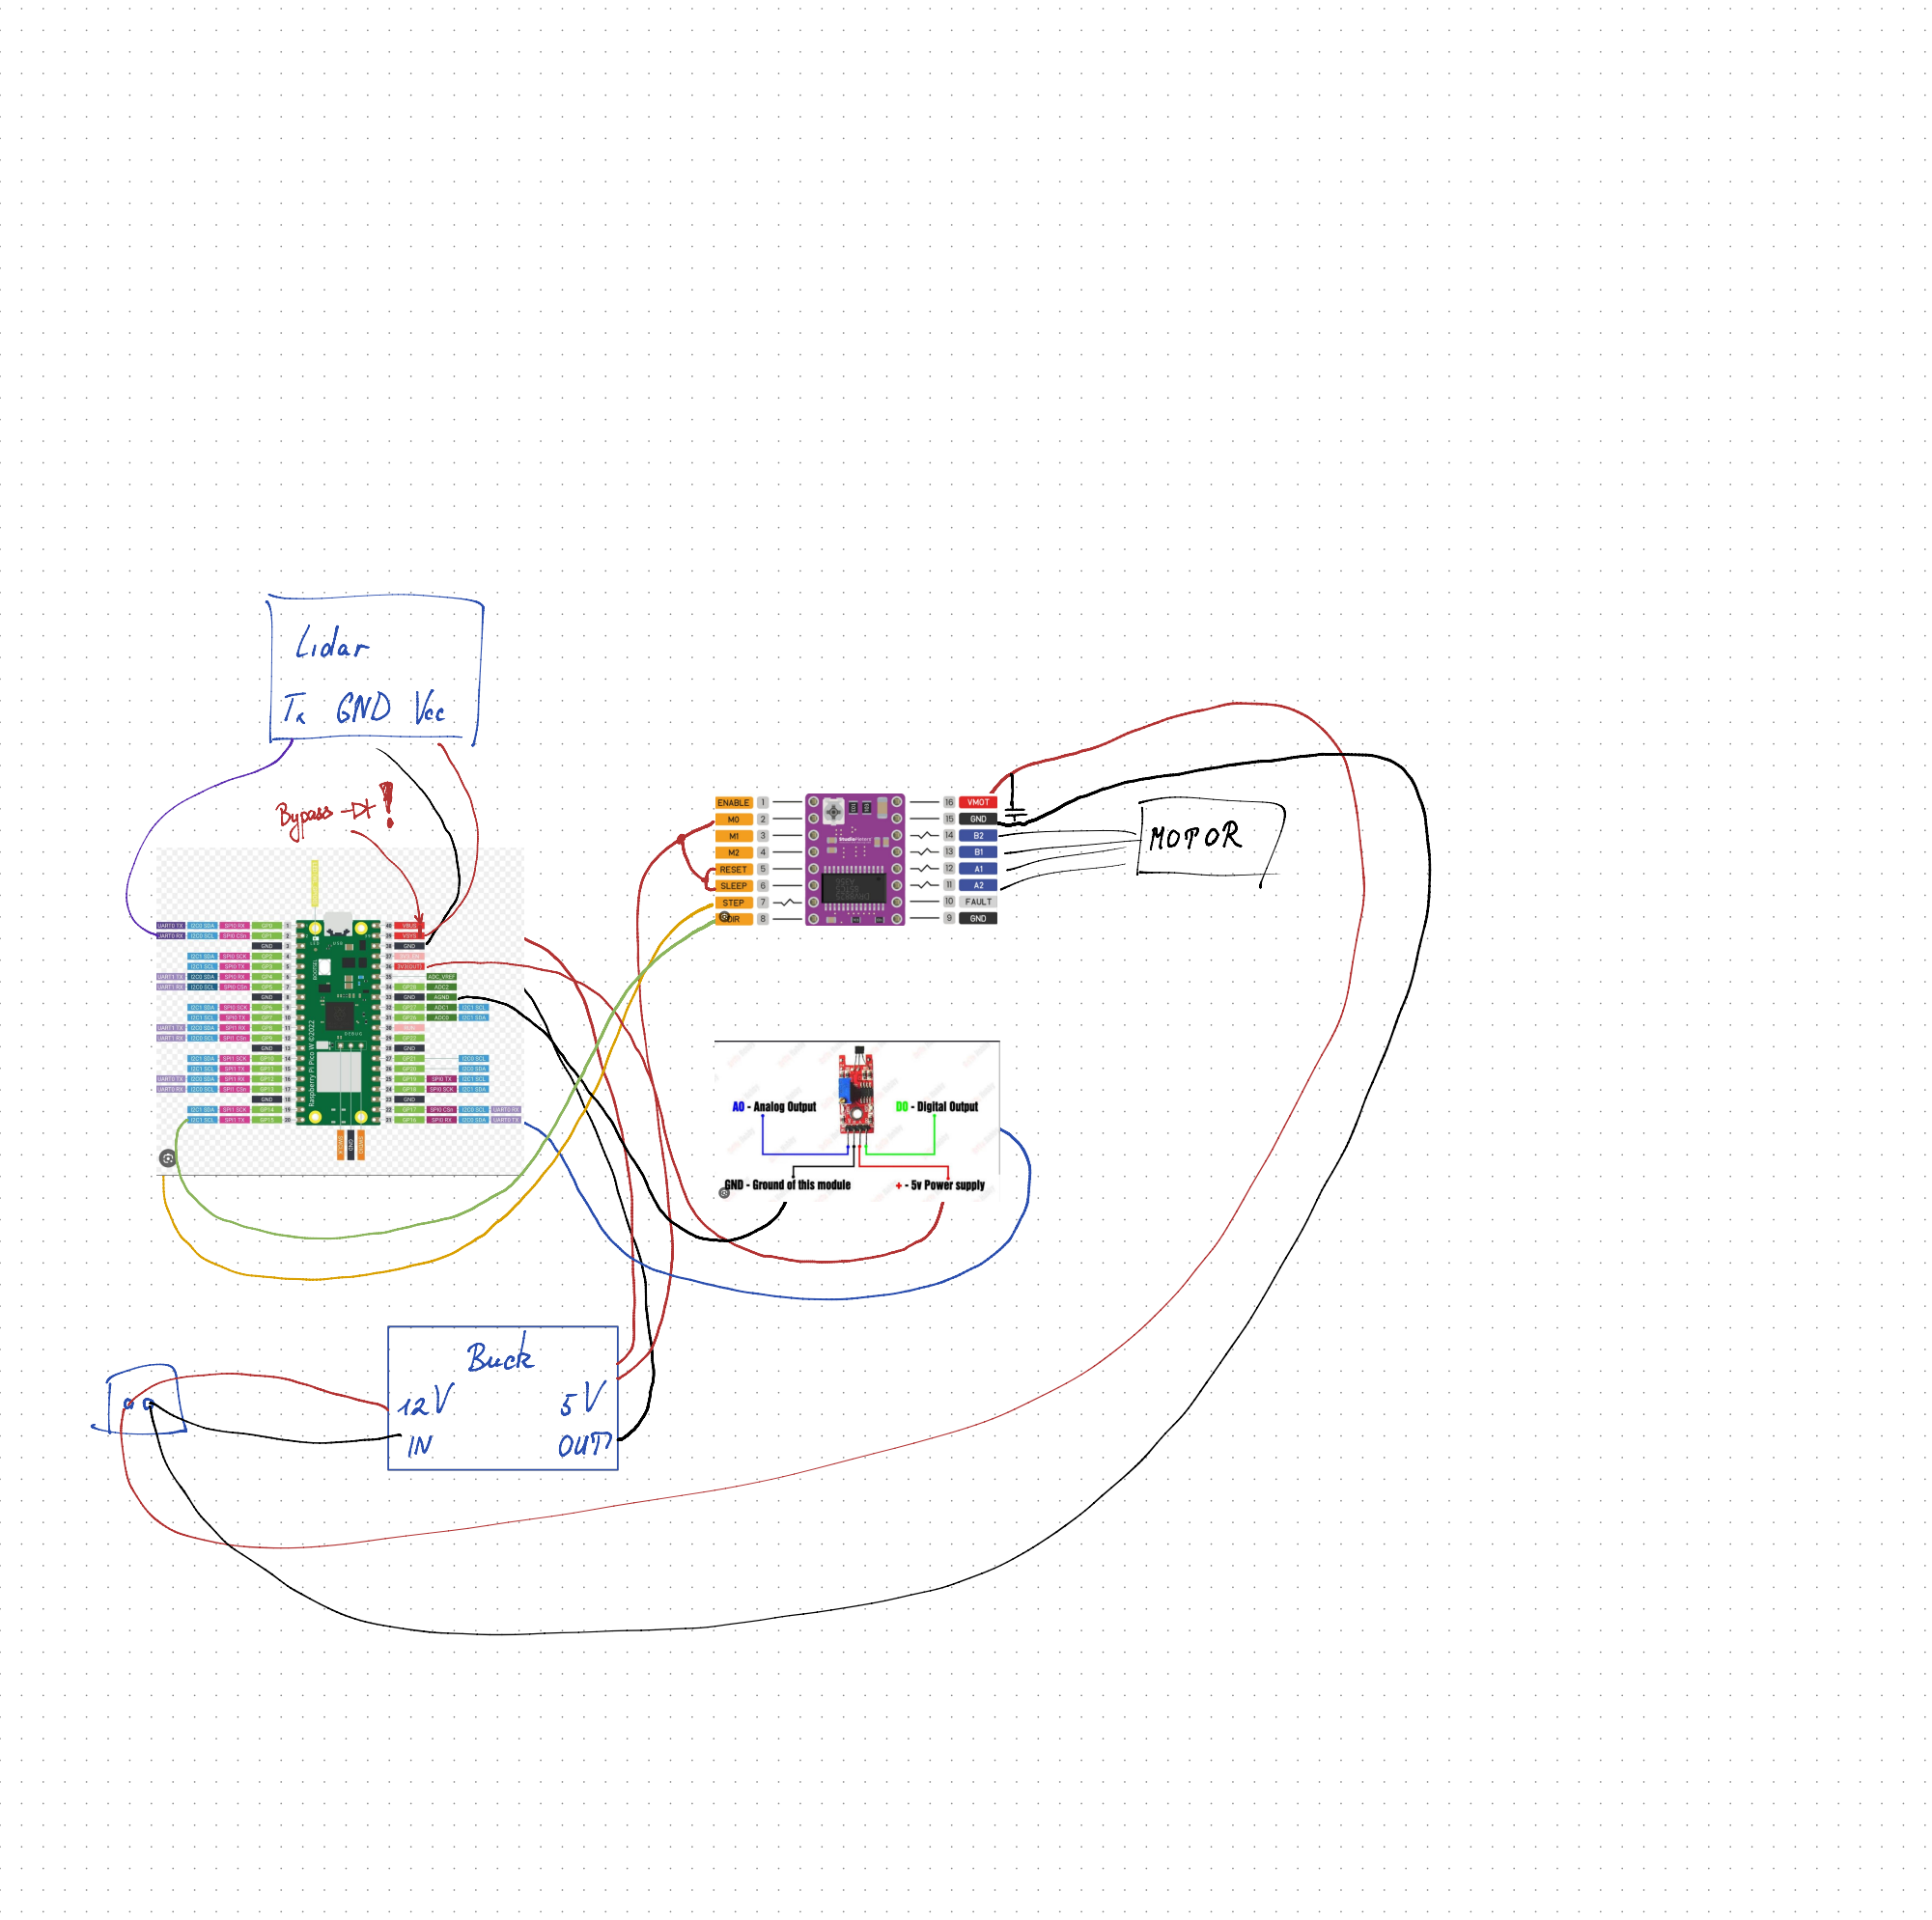
[picture p109: page 1]
