DarqSh/bap-novosad/NSI/NSI_presentation/figures/electronic_design_presentation.pdf

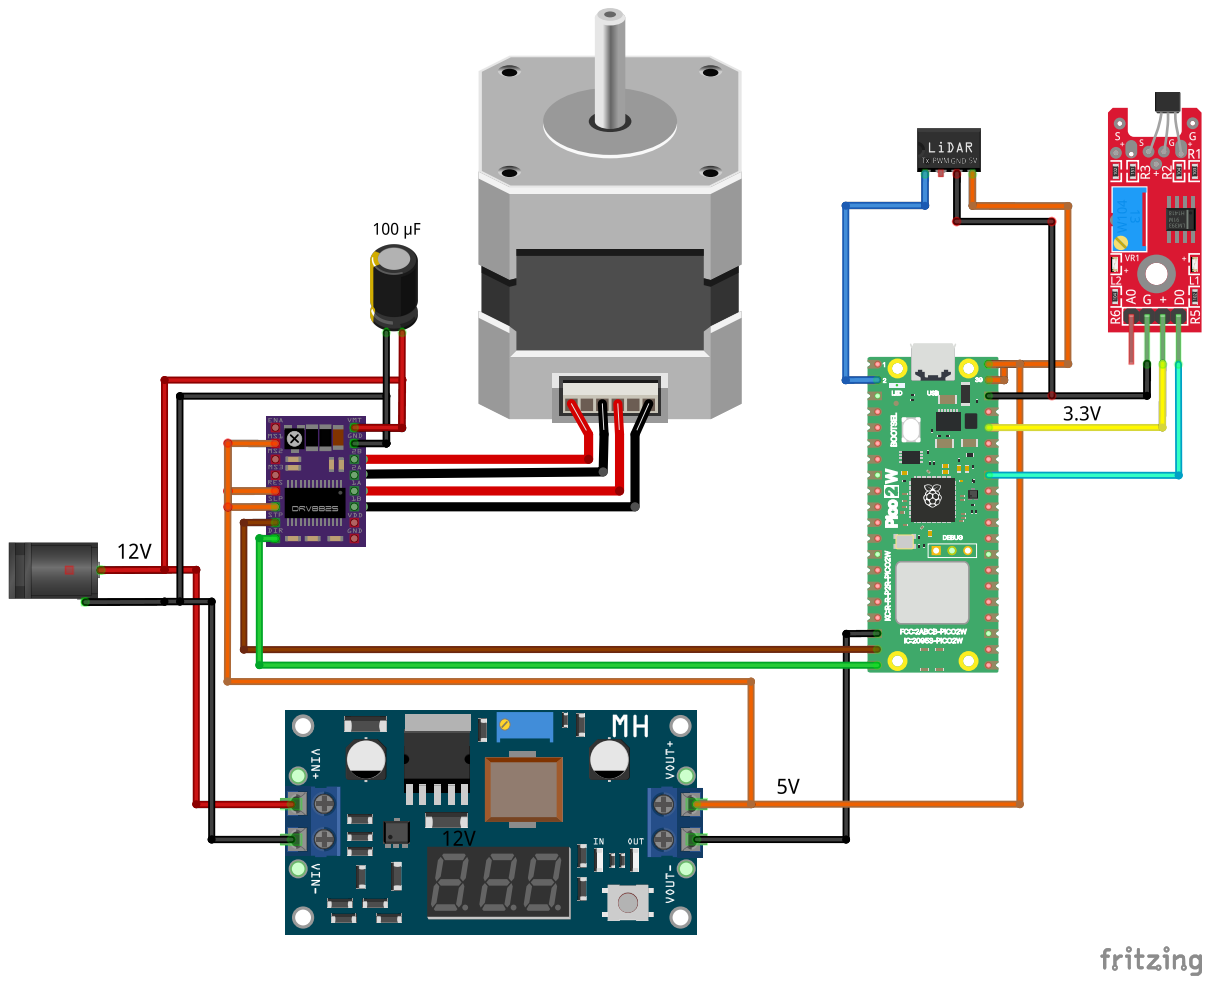
[picture p110: page 1]
