DarqSh/bap-novosad/NSI/NSI_presentation/figures/electronic_design.pdf

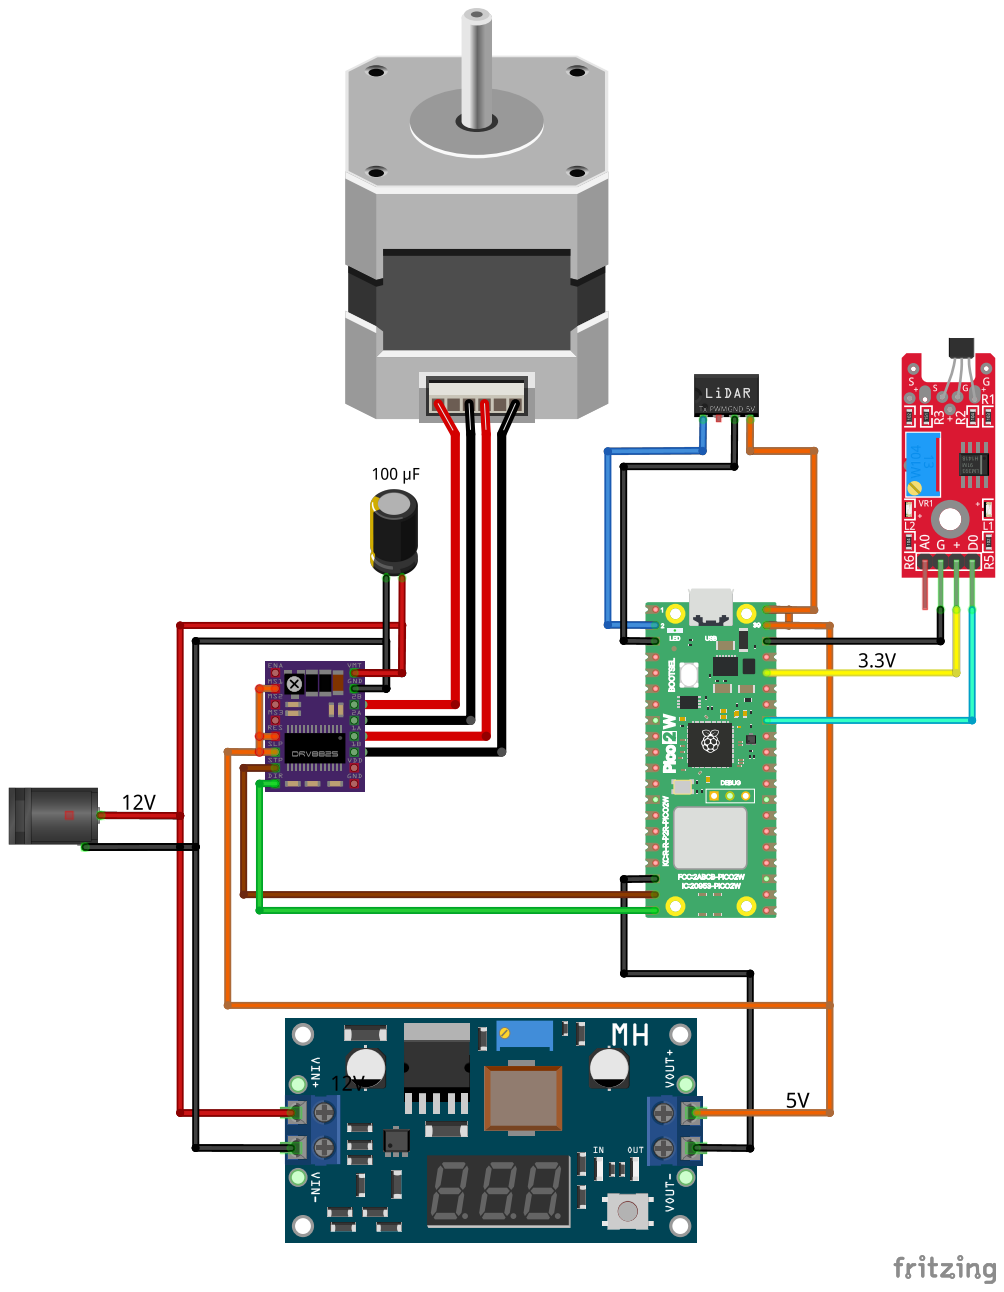
[picture p111: page 1]
