DarqSh/bap-novosad/defense_presentation/figures/platform_drawings.pdf

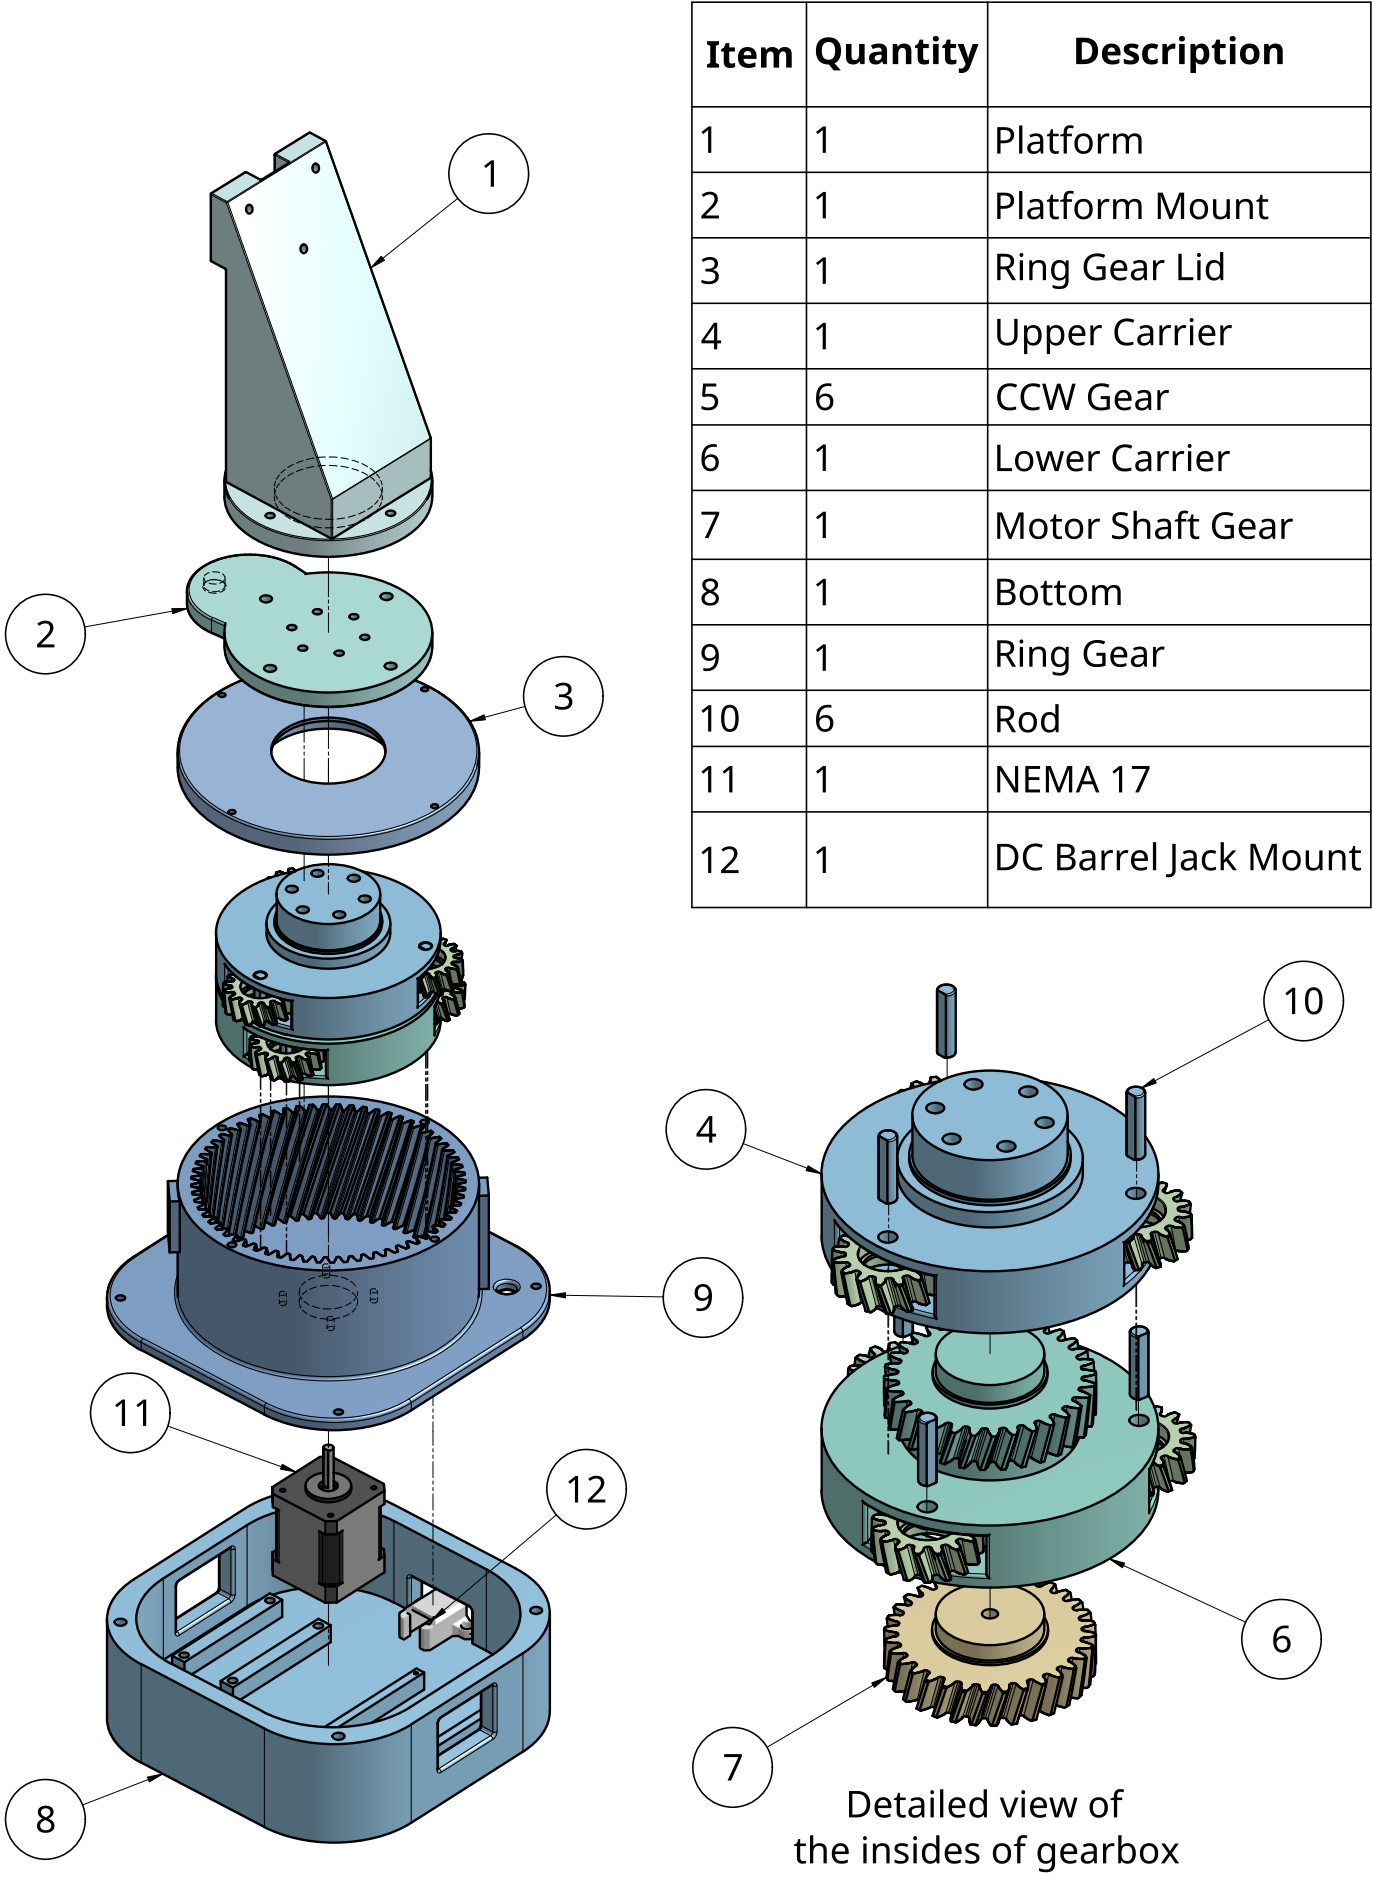
[picture p112: page 1]

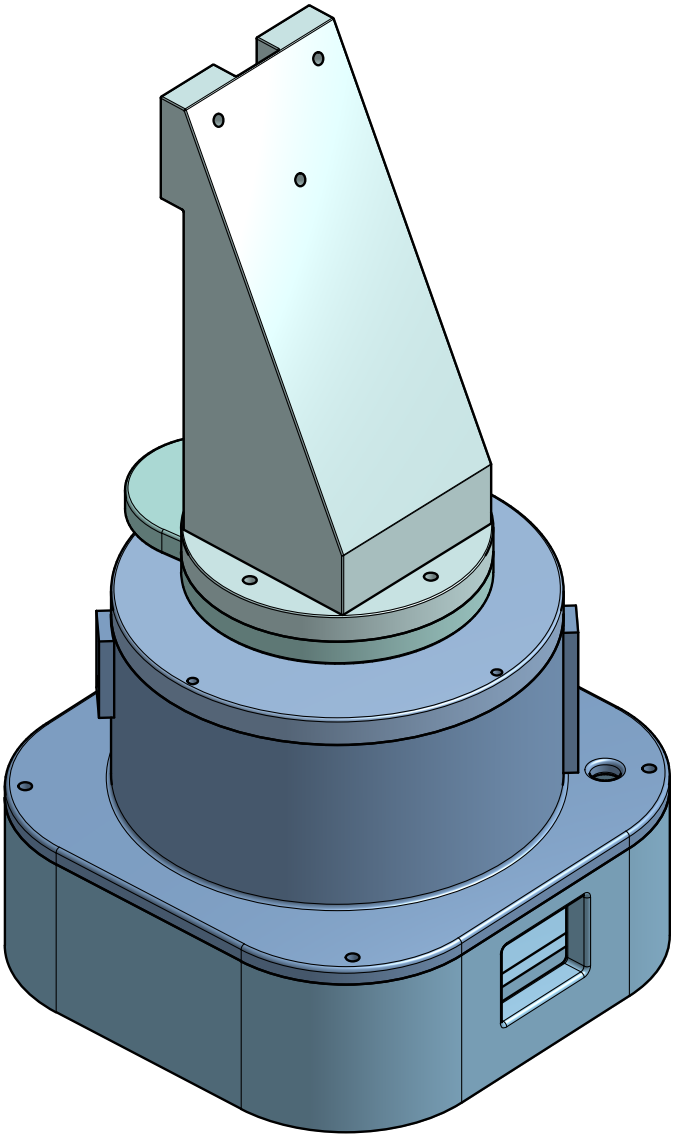
[picture p113: page 2]
