DarqSh/bap-novosad/(list of files, drawings)

Other design files:
fritzing_schematic_presentation.fzz
fritzing_schematic_thesis.fzz
