DarqSh/bap-novosad/Point Cloud Distribution/Point_distribution_measurement.py

#!/usr/bin/env python3

import numpy as np
import matplotlib.pyplot as plt
import matplotlib.patches as mpatches
import serial
from enum import Enum
import struct

# ----------------------------------------------------------------------
# System Constants
# ----------------------------------------------------------------------
# Serial port of the LIDAR unit
# SERIAL_PORT = "/dev/ttyUSB0"
SERIAL_PORT = "/dev/ttyUSB0"
# At the default rotation speed (~3600 deg/s) the system outputs about 
# 480 measurements in a full rotation. We want to plot at least this
# many in order to get a 360 degree plot
MEASUREMENTS_PER_PLOT = 480
# System will plot between +/-PLOT_MAX_RANGE on both X and Y axis
PLOT_MAX_RANGE = 1.0 # in meters
# Set the plot area to autoscale to the max distance in X or Y
PLOT_AUTO_RANGE = False
# Show the confidence as a colour gradiant on the plot
PLOT_CONFIDENCE = True
# Set the colour gradiant to use. See this URL for options:
# https://matplotlib.org/stable/gallery/color/colormap_reference.html
PLOT_CONFIDENCE_COLOUR_MAP = "bwr_r"
# Enable debug messages
PRINT_DEBUG = True
# ----------------------------------------------------------------------
# Main Packet Format
# ----------------------------------------------------------------------
# All fields are little endian
# Header (1 byte) = 0x54
# Length (1 byte) = 0x2C (assumed to be constant)
# Speed (2 bytes) Rotation speed in degrees per second
# Start angle (2 bytes) divide by 100.0 to get angle in degrees
# Data Measurements (MEASUREMENT_LENGTH * 3 bytes)
#                   See "Format of each data measurement" below
# Stop angle (2 bytes) divide by 100.0 to get angle in degrees
# Timestamp (2 bytes) In milliseconds
# CRC (1 bytes) Poly: 0x4D, Initial Value: 0x00, Final Xor Value: 0x00
#               Input reflected: False, Result Reflected: False
#               http://www.sunshine2k.de/coding/javascript/crc/crc_js.html
# Format of each data measurement
# Distance (2 bytes) # In millimeters
# Confidence (1 byte)

# ----------------------------------------------------------------------
# Packet format constants
# ----------------------------------------------------------------------
# These do not vary
PACKET_LENGTH = 47
MEASUREMENT_LENGTH = 12 
MESSAGE_FORMAT = "<xBHH" + "HB" * MEASUREMENT_LENGTH + "HHB"

State = Enum("State", ["SYNC0", "SYNC1", "SYNC2", "LOCKED", "UPDATE_PLOT"])

# DISTRIBUTION MEASUREMENT GLOBAL VARIABLES
Distribution_values = []
distribution_angle = 270
distribution_angle_tolerance = 0.1 # twosided!!! Also step size in angle between measurements is 0.7, so don't go over 0.35 for angle tolerance
# END




def parse_lidar_data(data):
    # Extract data
    length, speed, start_angle, *pos_data, stop_angle, timestamp, crc = \
        struct.unpack(MESSAGE_FORMAT, data)
    # Scale values
    start_angle = float(start_angle) / 100.0
    stop_angle = float(stop_angle) / 100.0
    # Unwrap angle if needed and calculate angle step size
    if stop_angle < start_angle:
        stop_angle += 360.0
    step_size = (stop_angle - start_angle) / (MEASUREMENT_LENGTH - 1)
    # Get the angle for each measurement in packet
    angle = [start_angle + step_size * i for i in range(0,MEASUREMENT_LENGTH)]
    distance = pos_data[0::2] # in millimeters
    confidence = pos_data[1::2]

    global Distribution_values
    global distribution_angle
    global distribution_angle_tolerance
    if start_angle <= distribution_angle and distribution_angle <= stop_angle:
        for i in range(0,len(angle)):
            if (distribution_angle-angle[i])<distribution_angle_tolerance:
                Distribution_values.append(distance[i])
                break

    if PRINT_DEBUG:
        print(length, speed, start_angle, *pos_data, stop_angle, timestamp, crc)
    return list(zip(angle, distance, confidence))



def get_xyc_data(measurements):
    # Unpack the tuples
    angle = np.array([measurement[0] for measurement in measurements])
    distance = np.array([measurement[1] for measurement in measurements])
    confidence = np.array([measurement[2] for measurement in measurements])
    # Convert to cartesian coordinates in meters
    x = np.sin(np.radians(angle)) * (distance / 1000.0)
    y = np.cos(np.radians(angle)) * (distance / 1000.0)
    return x, y, confidence

def outlier_filter(Distribution_values, mean, std, var, distribution_range):
    Filter_values = []
    for value in Distribution_values:
        if (mean - std-50) <= value <= (mean + std+50):
            Filter_values.append(value)
    filter_mean = np.mean(Filter_values)
    filter_std = np.std(Filter_values)
    filter_var = np.var(Filter_values)
    filter_range = max(Filter_values) - min(Filter_values)+1
    print("Previous variance: ", var, " New variance: ", filter_var)
    return Filter_values, filter_mean, filter_std, filter_var, filter_range

running = True

def on_plot_close(event):
    global Distribution_values
    global distribution_angle
    global running

    mean = np.mean(Distribution_values)
    var = np.var(Distribution_values)
    std = np.std(Distribution_values)
    distribution_range = max(Distribution_values) - min(Distribution_values)+1

    # basic outlier filtering (might change later, currently +- 1 std with some leeway, maybe deleting the values by the size of a bin would be better)
    Distribution_values, mean, std, var, distribution_range = outlier_filter(Distribution_values, mean, std, var, distribution_range)

    plt.ioff()
    plt.figure()
    print(Distribution_values)
    plt.hist(Distribution_values, bins=distribution_range, alpha=0.7)

    plt.axvline(mean, color='r', linestyle='--', linewidth=1, label = f"Mean: {mean:.2f} mm")
    plt.axvline(mean+std, color='g', linestyle=':', linewidth=1, label = f"Mean+std: {mean+std:.2f} mm")
    plt.axvline(mean-std, color='g', linestyle=':', linewidth=1, label = f"Mean-std: {mean-std:.2f} mm")

    # adds variance to legend
    ax = plt.gca()
    handles, labels = ax.get_legend_handles_labels()
    var_patch = mpatches.Patch(color='none', label=f'Variance: {var:.2f} mm²')
    handles.append(var_patch)

    plt.title("Distribution for distance " + f"{round(mean)/1000:.2f}" + " m")
    plt.legend(handles=handles)
    plt.show()
    running = False


if __name__ == "__main__":
    # Connect up to the LIDAR serial port
    lidar_serial = serial.Serial(SERIAL_PORT,  230400, timeout=0.5)

    # Set up initial state
    measurements = []
    data = b''
    state = State.SYNC0


    # Set up matplotlib plot
    plt.ion()
    # Force a square aspect ratio
    plt.rcParams['figure.figsize'] = [10, 10]
    plt.rcParams['lines.markersize'] = 2.0
    if PLOT_CONFIDENCE:
        graph = plt.scatter([], [], c=[], marker=".", vmin=0,
                            vmax=255, cmap=PLOT_CONFIDENCE_COLOUR_MAP)
    else:
        graph = plt.plot([], [], ".")[0]
    # Set up the program to shutdown when the plot is closed
    graph.figure.canvas.mpl_connect('close_event', on_plot_close)
    # Limit to +/- PLOT_MAX_RANGE meters
    plt.xlim(-PLOT_MAX_RANGE,PLOT_MAX_RANGE)
    plt.ylim(-PLOT_MAX_RANGE,PLOT_MAX_RANGE)

    # Main state machine
    while running:
        # Find 1st header byte
        if state == State.SYNC0:
            data = b''
            measurements = []
            if lidar_serial.read() == b'\x54':
                data = b'\x54'
                state = State.SYNC1
        # Find 2nd header byte
        # Technically this is the length field but the packet length
        # is fixed, so it can be treated as a constant.
        elif state == State.SYNC1:
            if lidar_serial.read() == b'\x2C':
                state = State.SYNC2
                data += b'\x2C'
            else:
                state = State.SYNC0
        # Read remainder of the packet (PACKET_LENGTH minus the 2 header
        # bytes we have already read).
        elif state == State.SYNC2:
            data += lidar_serial.read(PACKET_LENGTH - 2)
            if len(data) != PACKET_LENGTH:
                state = State.SYNC0
                continue
            measurements += parse_lidar_data(data)
            state = State.LOCKED
        elif state == State.LOCKED:
            data = lidar_serial.read(PACKET_LENGTH)
            if data[0] != 0x54 or len(data) != PACKET_LENGTH:
                print("WARNING: Serial sync lost")
                state = State.SYNC0
                continue
            measurements += parse_lidar_data(data)
            if len(measurements) > MEASUREMENTS_PER_PLOT:
                state = State.UPDATE_PLOT
        elif state == State.UPDATE_PLOT:
            x, y, c = get_xyc_data(measurements)
            # Work out max coordinate, and set the scale based on this.
            # Force a 1:1 aspect ratio
            if PLOT_AUTO_RANGE:
                mav_val = max([max(abs(x)), max(abs(y))]) * 1.2
                plt.xlim(-mav_val,mav_val)
                plt.ylim(-mav_val,mav_val)
            # Clear the previous data
            graph.remove()
            # Plot the new data
            if PLOT_CONFIDENCE:
                graph = plt.scatter(x, y, c=c, marker=".",
                                    vmin=0,vmax=255,
                                    cmap=PLOT_CONFIDENCE_COLOUR_MAP)
            else:
                graph = plt.plot(x,y,'b.')[0]
            
            x_line = [0, np.sin(np.radians(distribution_angle))*PLOT_MAX_RANGE]
            y_line = [0, np.cos(np.radians(distribution_angle))*PLOT_MAX_RANGE]
            plt.plot(x_line, y_line, 'r-', linewidth =2)
            # Show the new data
            plt.pause(0.00001)
            # Get the next packet
            state = State.LOCKED
            measurements = []
