DarqSh/bap-novosad/(commit log)

2025-09-27 Add code for IMU prototype
2025-10-24 Add Lidar_demo_continuous_plot.py
2025-11-09 Update notes on angle calculation; Add new graph with suggested gear ratios
2025-11-23 Add 'Choosing a Gear Ratio for the Rotating Platform' subsection to Design chapter
2025-11-23 Input 'tikz_platform' into the 'Proposed Design of a 360\deg LiDAR Platform' subsection
2025-11-25 Add stepper motor thesis to bibliography
2025-11-25 Add stepper motor photo
2025-11-25 Add 'pgfplots' package for printing out graphs
2025-11-25 Add 'tilt_pointCloud.tex' to 'Using a 2D \gls{lidar} Mounted on a Tilting Platform' subsection
2025-11-25 Minor text changes in 'Proposed Design of a 360$\degree$ \gls{lidar} Platform' subsection
2025-11-25 Finish 'Proposed Design of a 360$\degree$ \gls{lidar} Platform' subsection
2025-11-25 Add lidar photo image in introduction chapter
2025-11-26 Finish 'Choosing a Gear Ratio for the Rotating Platform' subsection
2025-11-26 Change dimensions format for lidar in 'Introduction'
2026-02-15 Add working uart_lidar->pico->usb_pc communication prototype code in C + notes on improvement
    Made entirely with the help of ChatGPT and Grok just to try out what is Pico 2 capable of.
    The code definitely needs some refinement that will be done after obtaining the needed knowledge from NSI course.
2026-02-15 Add bibliography entry for planetary gearbox article
2026-02-15 Change the name of a directory with C uart code
2026-02-15 Add working uart_lidar->pico->usb_pc communication prototype code in Micropython + notes on building .uf2 from Micropython code
    Made with the help of ChatGPT and Grok, just to get the basic communication working and trying out Micropython->.uf2 building workflow.
2026-03-14 Add .uf2 build for uart->serial communication case
2026-03-14 Add semi-functional uart_lidar->pico->wifi_pc communication prototype code in Micropython + notes with what has yet to be done/improved
2026-03-18 Update bibliography with info about microstepping vs gear reduction
2026-03-18 Add 3D models for printing
    [Bottom.stl, DC housing.stl, Gear CCW x6.stl, Lower Carrier.stl, Motor Shaft Gear CW.stl, Platform Mount.stl, Platform.stl, Ring Gear Lid.stl]
2026-03-24 Move all parts inside "3D models" folder into "v1.0" subfolder
    [Bottom.stl, DC housing.stl, Gear CCW x6.stl, Lower Carrier.stl, Motor Shaft Gear CW.stl, Platform Mount.stl, Platform.stl, Ring Gear Lid.stl]
2026-03-24 Add "v1.1" to "3D models" (changelog is inside)
    [Bottom.stl, CCW Gear x6.stl, DC housing.stl, Lower Carrier.stl, Motor Shaft Gear.stl, Platform Mount.stl, Platform.stl, Ring Gear Lid.stl]
2026-05-05 Lots of changes, see below Apply instructor feedback from TPS course: Correctly incorporate scan spacing equation into the text (previously it was introduced with a colon sign) Remove possessive 's i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
    Change date on title page to May 2026 (previously it was November 2025)
    Reorganise the folder structure (separating subsections and their contents into subfolders inside section folders)
2026-05-17 Change title name, keywords; insert zadani_prace
2026-05-17 Add attribution of DC housing model
2026-05-17 Add footnote to wiring diagram
2026-05-17 Add attribution of demo code for lidar
2026-05-17 Update BOM
2026-05-17 Lots of changes change computer to PC in abstract correct indentation near citation in introduction rewrite conclusion part on why a larger motor was incorrectly selected rewrite the definition of re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
2026-05-17 Insert prohlaseni
2026-05-20 Add fritzing schematics
    [fritzing_schematic_presentation.fzz, fritzing_schematic_thesis.fzz]
2026-05-22 Add appendix with attachments
2026-05-22 Add stepper.py attribution to text and fix GitLab link
2026-06-02 code/ changes: pc: Tweak misalignment correction in scan_angle_deg from -1.0 to -0.5 add filtering of garbage values produced by the lidar that are at a larger distance than the maximum range of the 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
    [main.py]
2026-06-02 Add align_demo/ to code/
    [pcd_2026.06.01_16:51:32_263851_source.ply, pcd_2026.06.01_16:53:58_264111_smallrotate.ply, pcd_2026.06.01_19:56:44_264167_ransacalign.ply]
2026-06-02 Add distance_measurement/ to code/
    [pcd_2026.06.01_16:51:32_263851_source.ply]
2026-06-02 Add better ransacalign scan (closed window) and add a photo of a strahov room dimensions
    [pcd_2026.06.02_20:37:36_263845_ransacalign.ply]
2026-06-08 Add printout of statistics to outlier removal code
